enisaslan/ea01/hw/doc/Screenshot_20250719_232026.png

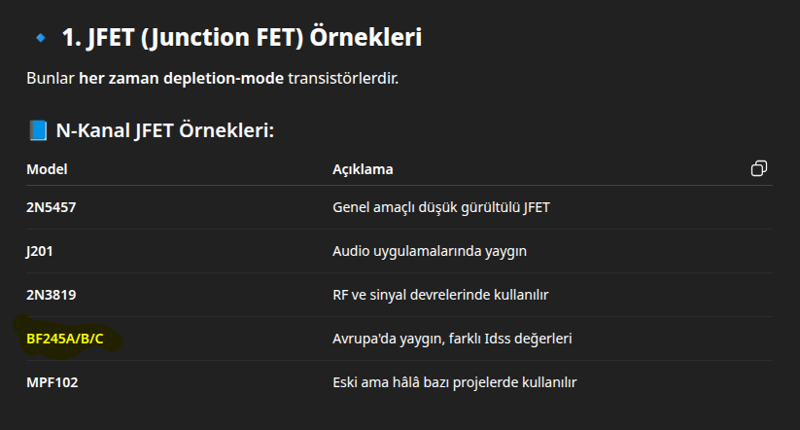
hw/doc/Screenshot_20250719_232026.png
