enisaslan/ea01/hw/ea01/3dModels/User Library-ABM3-2.stp

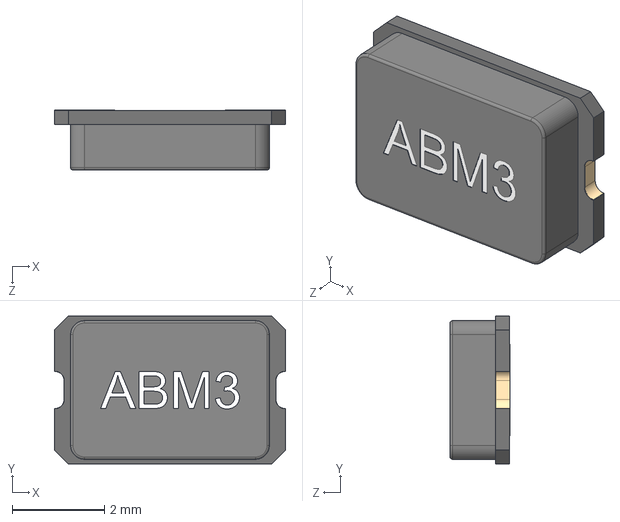
[picture p2: CAD file, 2025-09-29]
hw/ea01/3dModels/User Library-ABM3-2.stp
5.00 x 3.20 x 1.30 mm
