enisaslan/ea01/hw/ea01/3dModels/terminal_blocks_a-tb508-tc02.stp

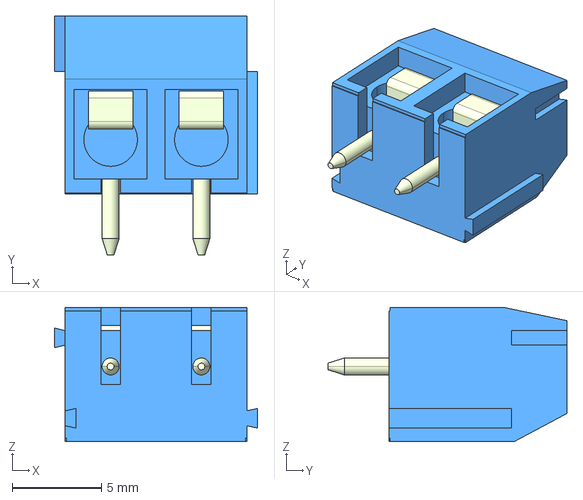
[picture p3: CAD file, 2025-09-29]
hw/ea01/3dModels/terminal_blocks_a-tb508-tc02.stp
11.4 x 13.3 x 7.50 mm
