enisaslan/ea01/hw/ea01/3dModels/terminal_blocks_a-tb508vj02h.stp

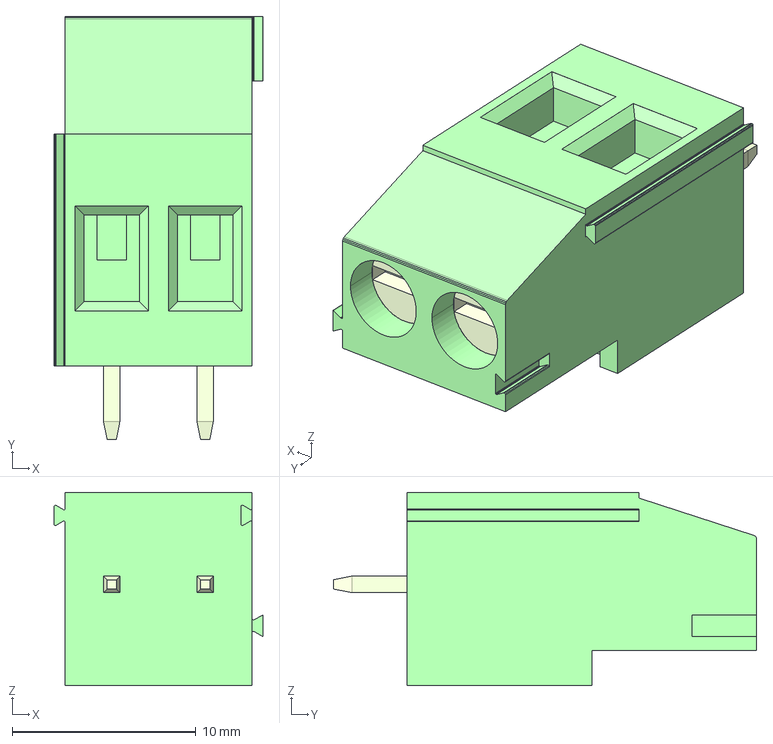
[picture p4: CAD file, 2025-09-29]
hw/ea01/3dModels/terminal_blocks_a-tb508vj02h.stp
11.4 x 23.0 x 10.5 mm
