enisaslan/ea01/hw/ea01/3dModels/a-usbsb.stp

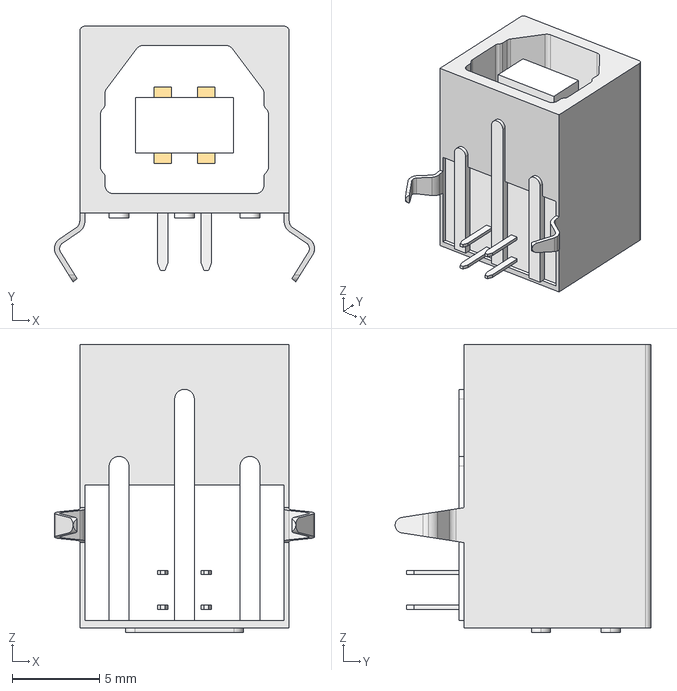
[picture p5: CAD file, 2025-09-29]
hw/ea01/3dModels/a-usbsb.stp
14.9 x 14.7 x 16.5 mm
