enisaslan/ea01/hw/ea01/3dModels/terminal_blocks_a-tb508-tc03.stp

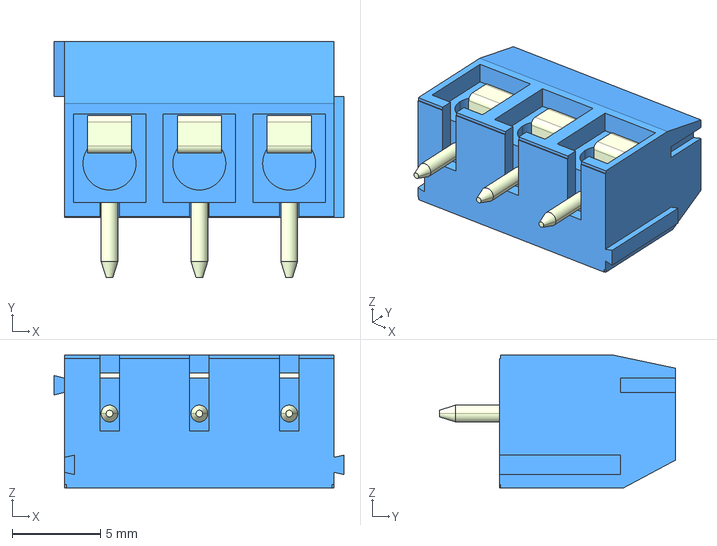
[picture p6: CAD file, 2025-09-29]
hw/ea01/3dModels/terminal_blocks_a-tb508-tc03.stp
16.4 x 13.3 x 7.50 mm
