enisaslan/ea01/hw/ea01/ea01.pdf

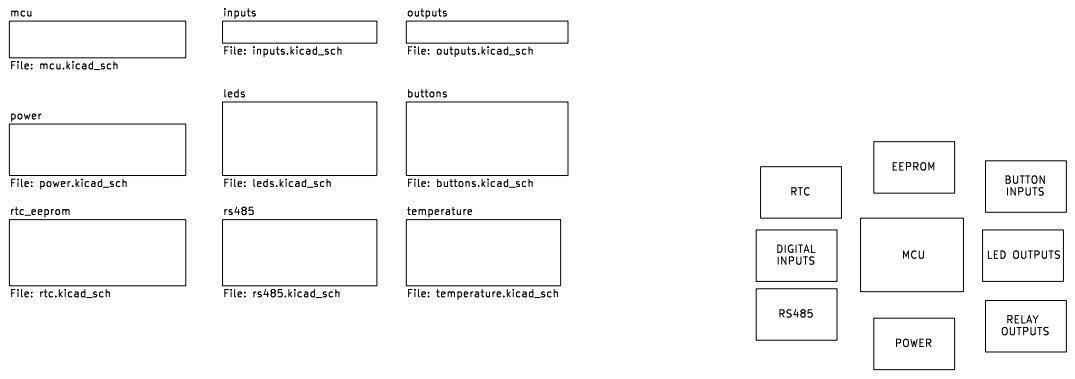
[picture p8: page 1]

power File: power.kicad_sch mcu File: mcu.kicad_sch

Id: 1/10 Title: File: ea01.kicad_sch Sheet: /

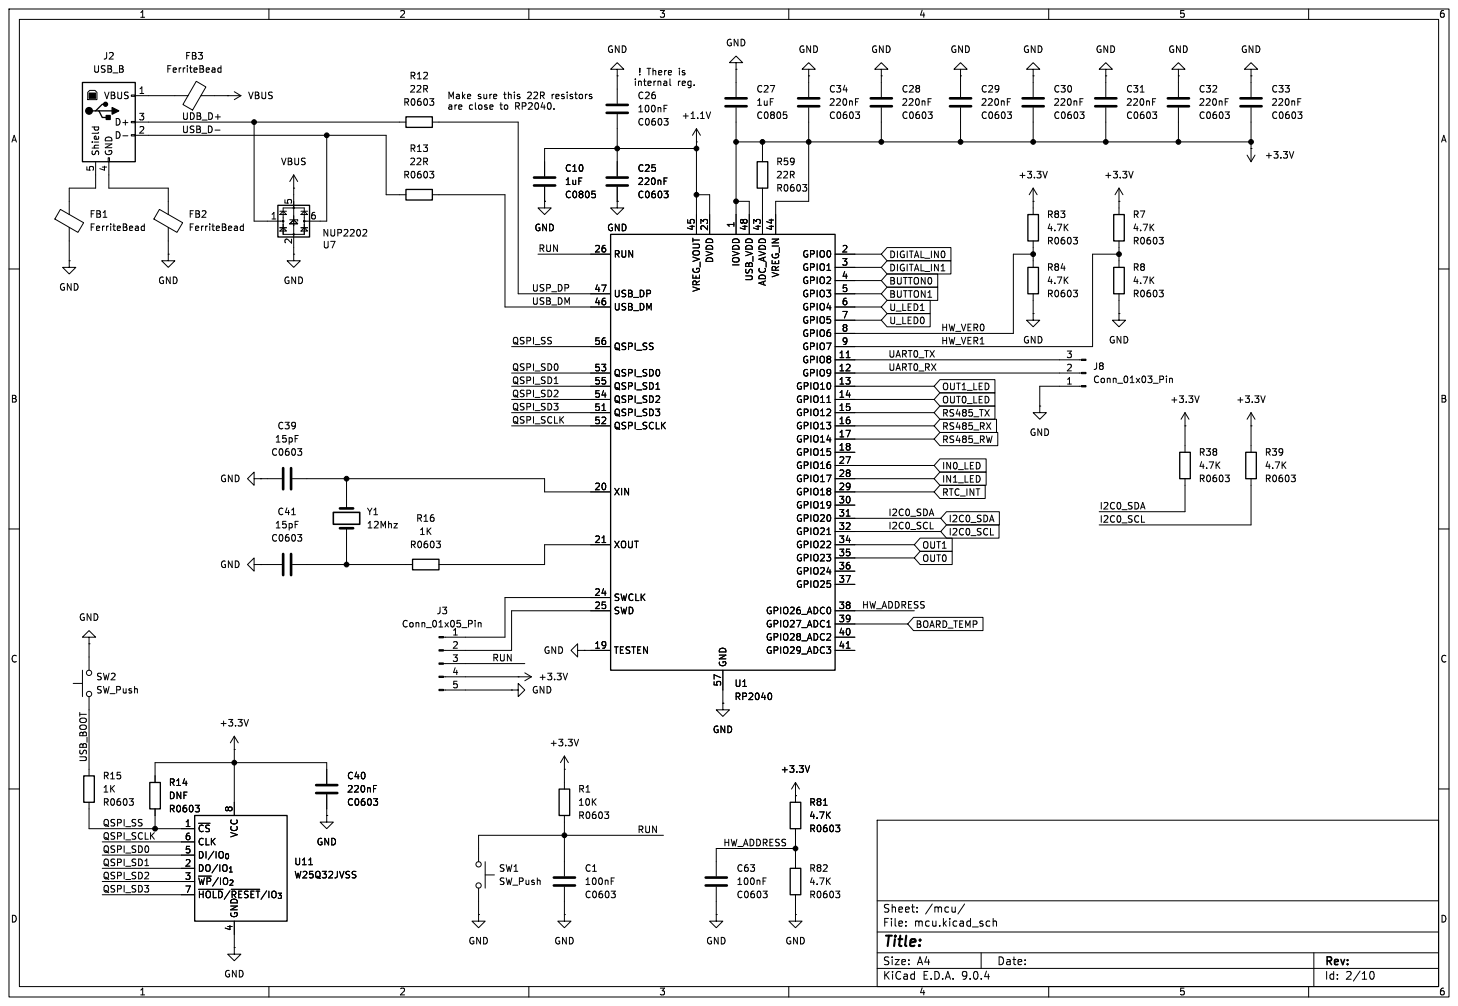
[picture p9: page 2]

Id: 2/10 Title: File: mcu.kicad_sch Sheet: /mcu/

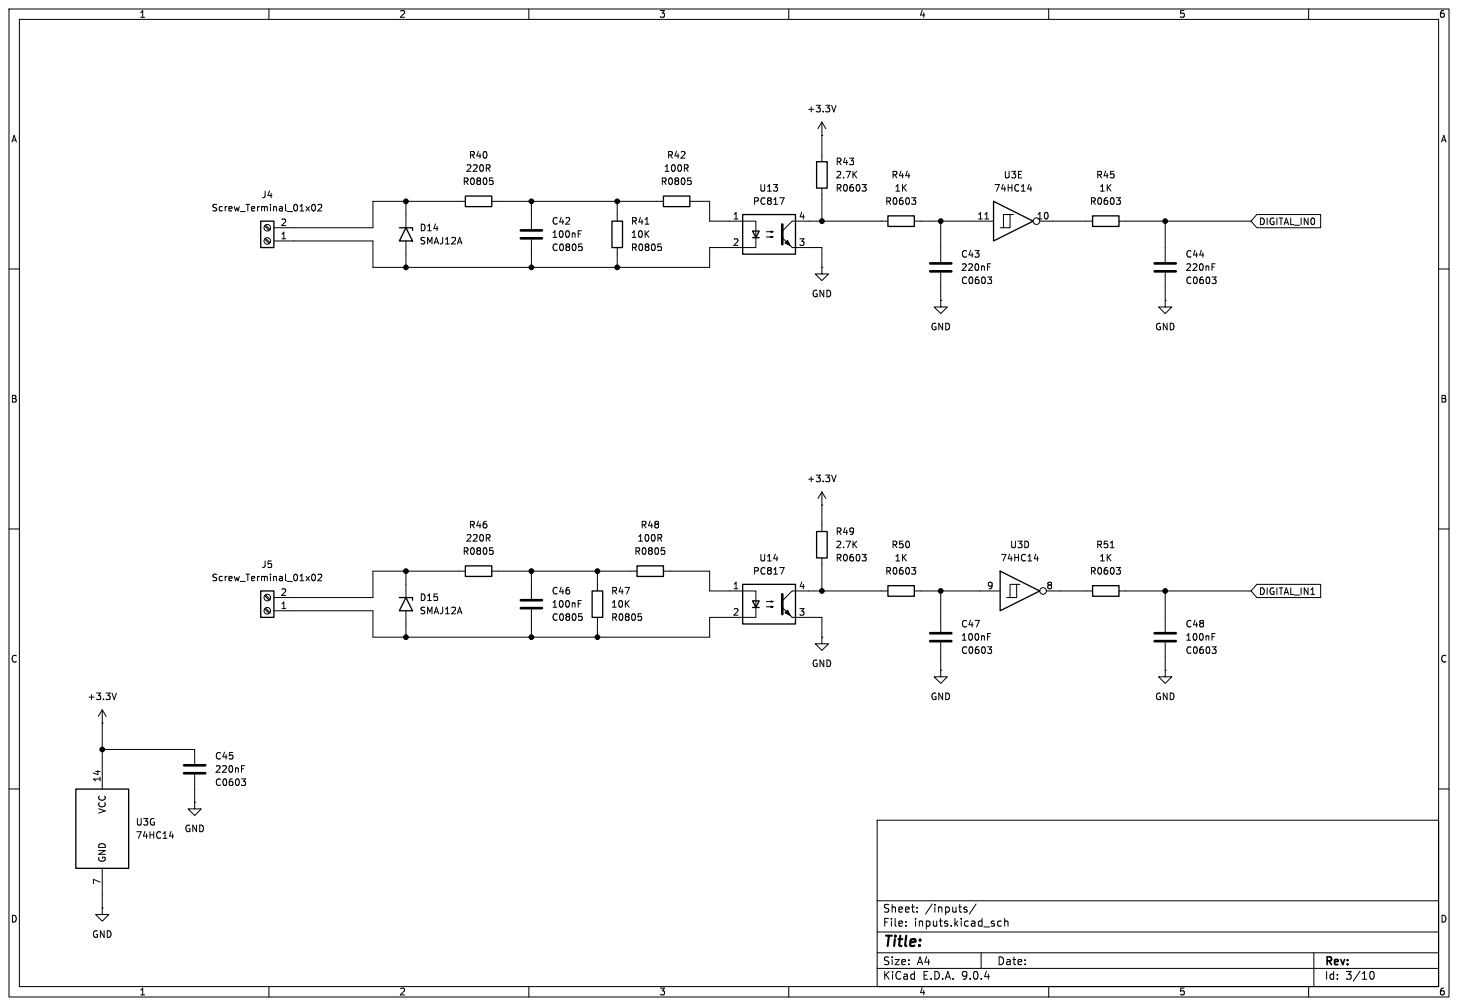
[picture p10: page 3]

Id: 3/10 Title: File: inputs.kicad_sch Sheet: /inputs/

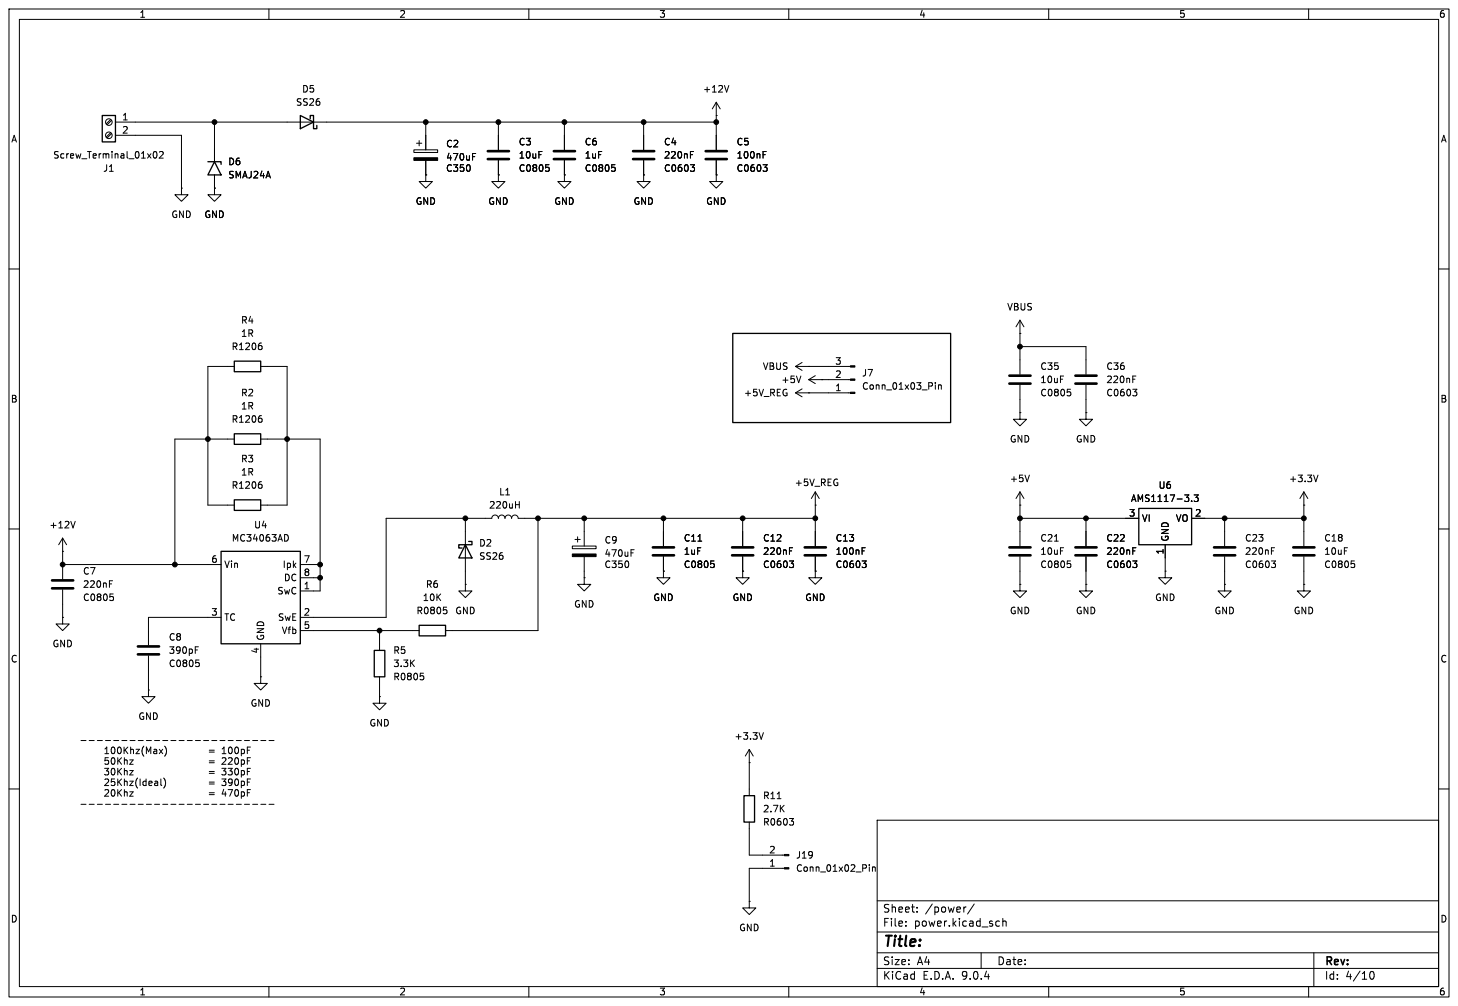
[picture p11: page 4]

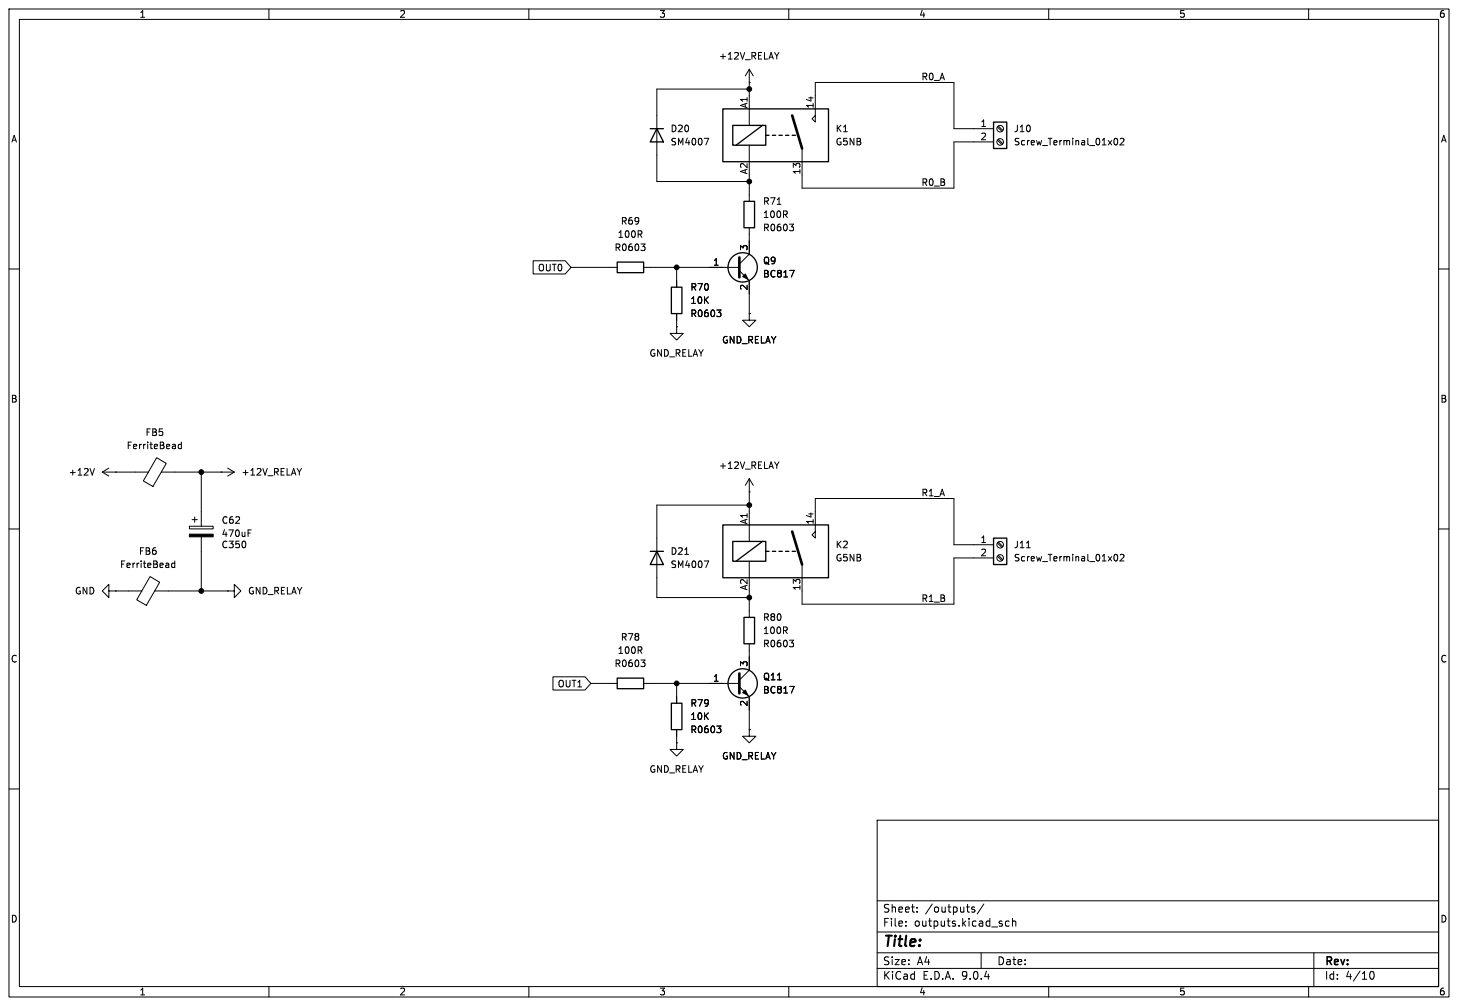
[picture p12: page 5]

Id: 4/10 Title: File: outputs.kicad_sch Sheet: /outputs/

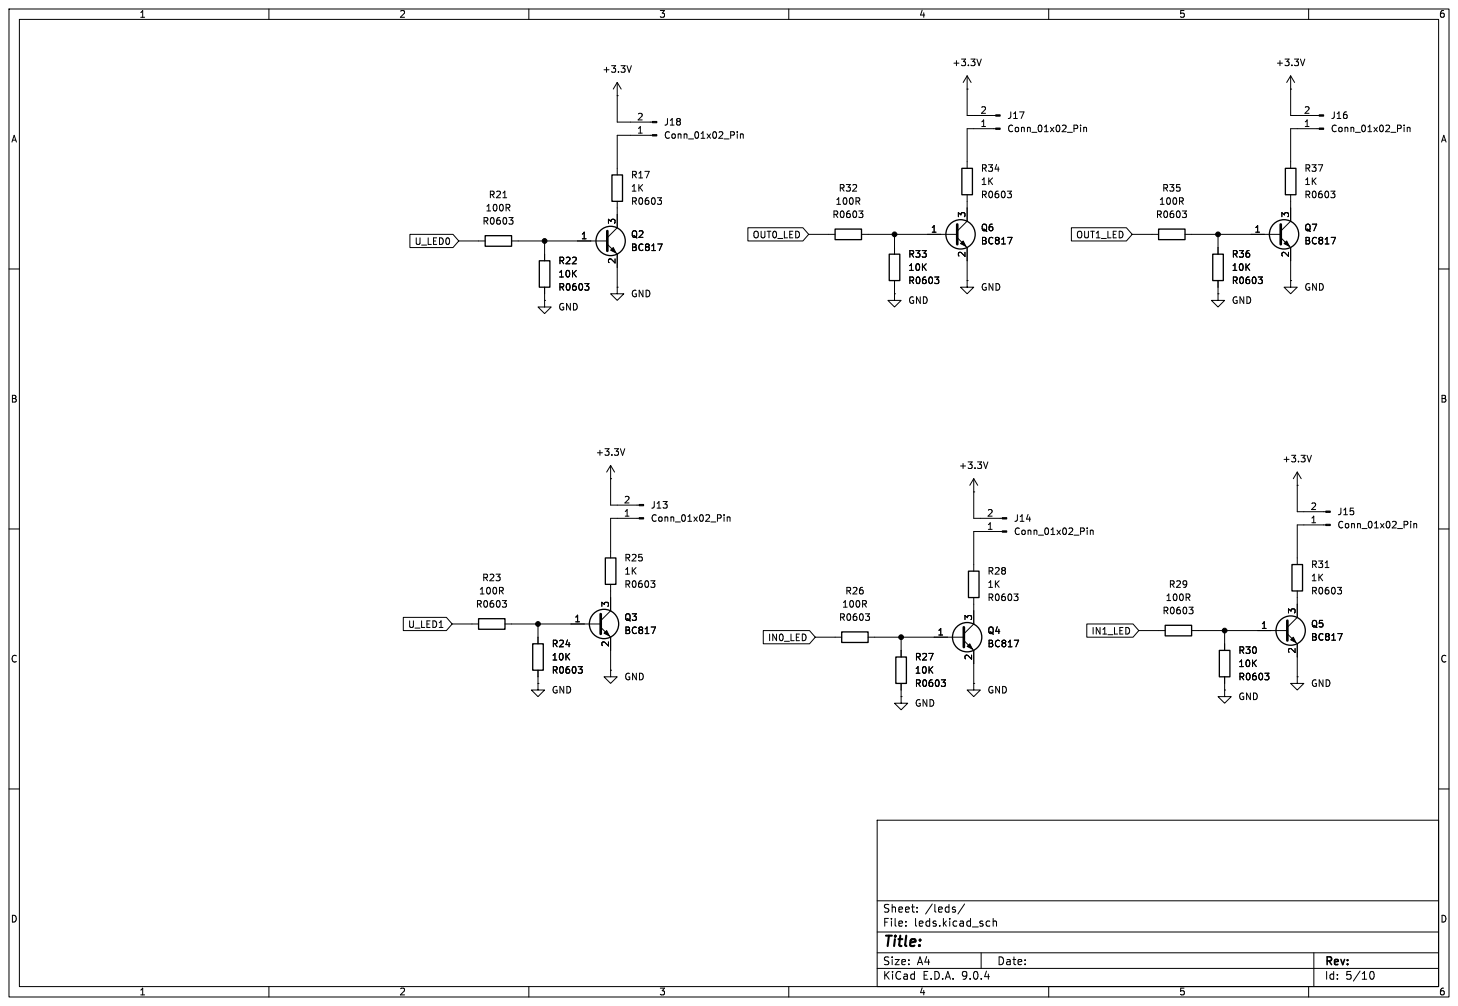
[picture p13: page 6]

Id: 5/10 Title: File: leds.kicad_sch Sheet: /leds/

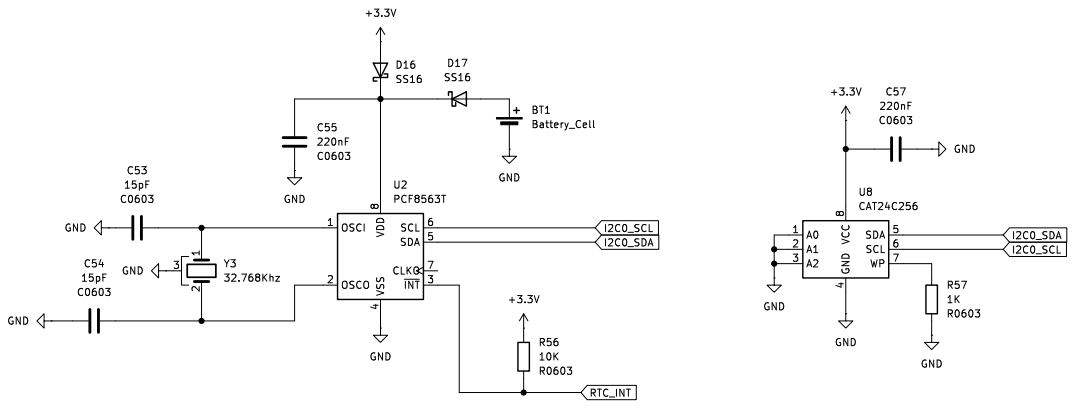
[picture p14: page 7]

4 SCL 6 SDA 5 CLKO 7 ~{INT}3 U2PCF8563T GND

4 SDA 5 SCL 6 WP 7 U8 CAT24C256 R56 GND
I2C0_SDA RTC_INT

File: rtc.kicad_sch Sheet: /rtc_eeprom/ Enis ASLAN

Id: 6/10 Title: RTC & EEPROM

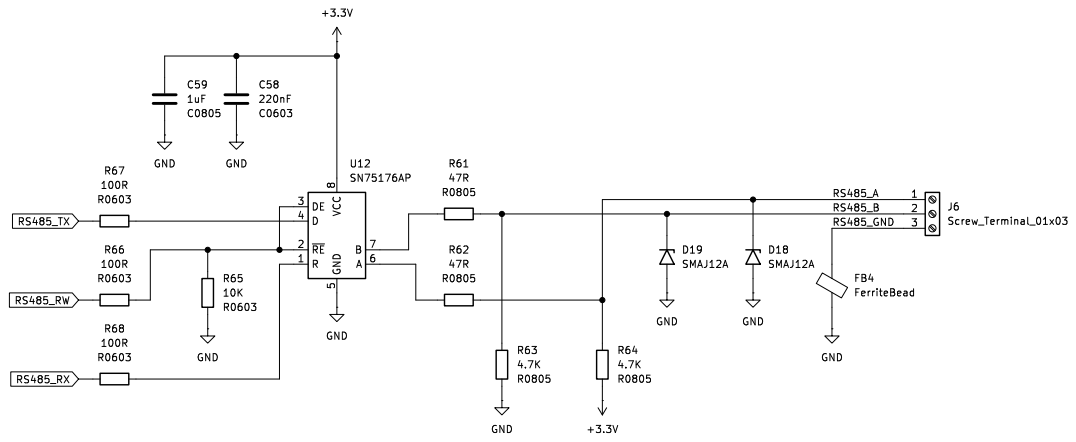
[picture p15: page 8]

Id: 7/10 Title: File: rs485.kicad_sch Sheet: /rs485/

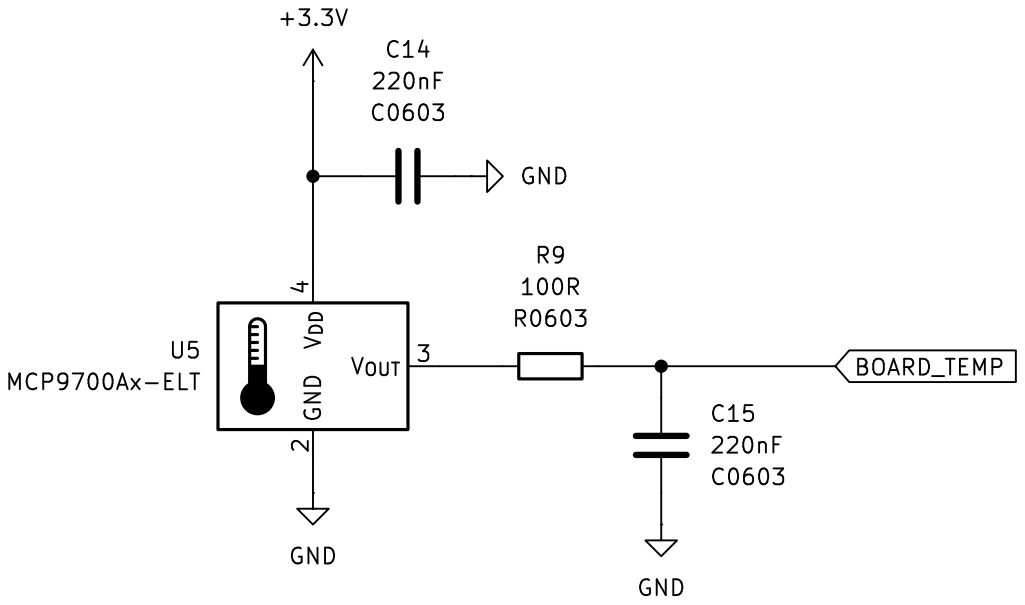
[picture p16: page 9]

Id: 8/10 Title: File: temperature.kicad_sch Sheet: /temperature/ GND

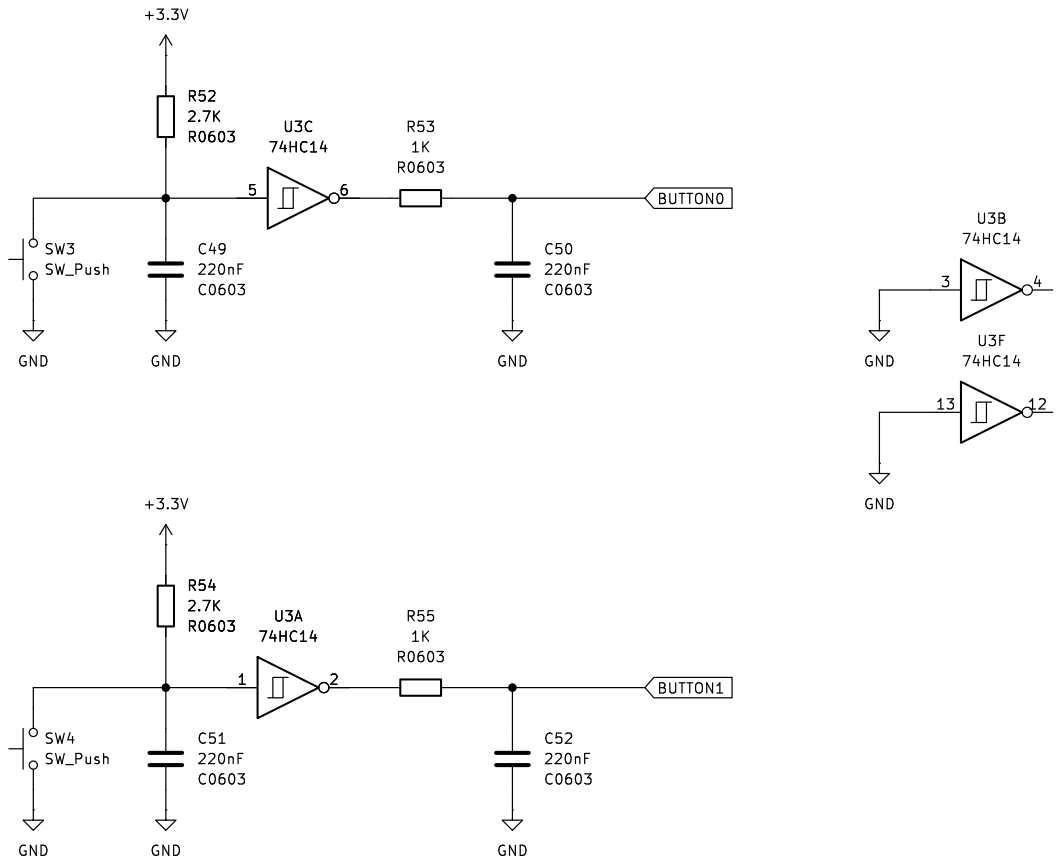
[picture p17: page 10]

Id: 9/10 Title: File: buttons.kicad_sch Sheet: /buttons/ C52
