enisaslan/ea01/hw/ea01/ea01.kicad_pcb

## KiCad design hw/ea01/ea01.kicad_pcb (2025-11-13)

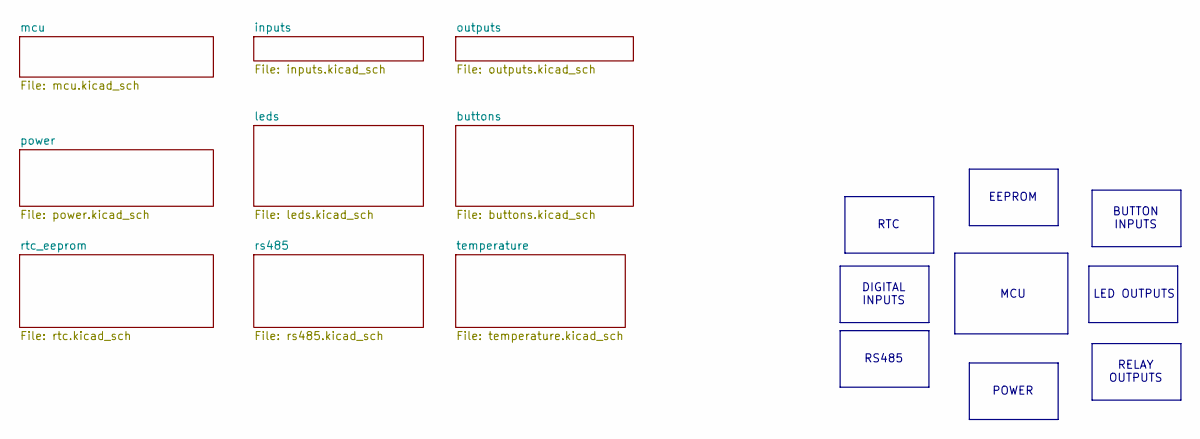
[picture p18: schematic ea01.kicad_sch]

Notes on the sheet:
DIGITAL INPUTS
EEPROM
LED OUTPUTS
MCU
RS485
RTC
BUTTON INPUTS
POWER
RELAY OUTPUTS

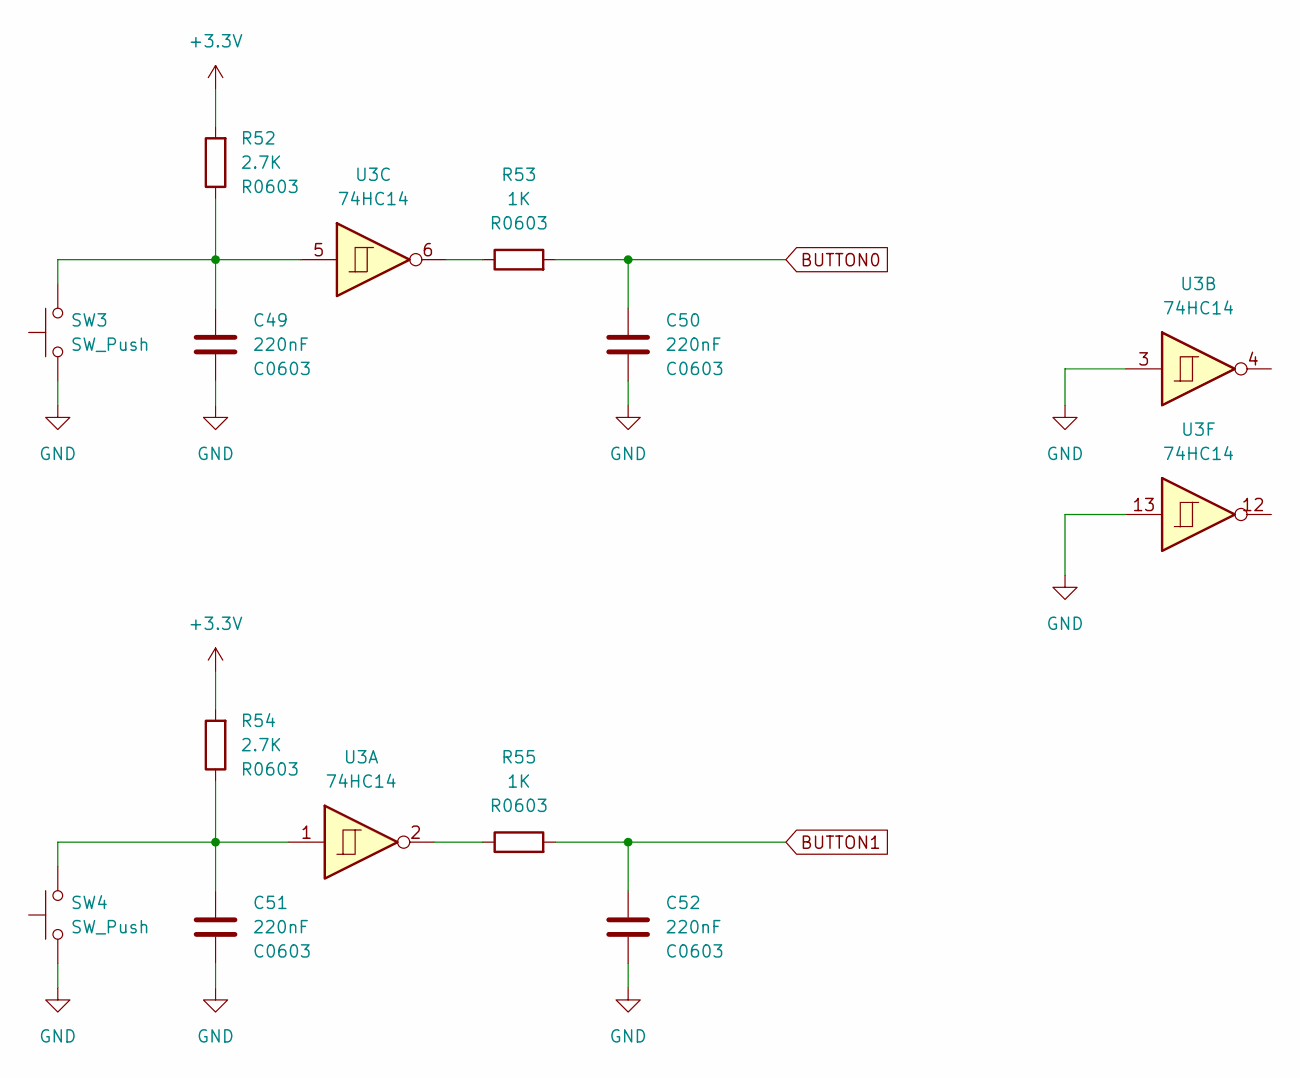
[picture p19: schematic buttons.kicad_sch]

Parts:
C49, C50, C51, C52: 220nF; C_0603_1608Metric
R52, R54: 2.7K; R_0603_1608Metric
R53, R55: 1K; R_0603_1608Metric
SW3, SW4: SW_Push; SW_PUSH_6mm_H5mm
U3: 74HC14; SOIC-14_3.9x8.7mm_P1.27mm

Connections:
+3.3V: R52.2, R54.2; also elsewhere on the board
BUTTON0: C50.1, R53.2; also elsewhere on the board
BUTTON1: C52.1, R55.2; also elsewhere on the board
GND: C49.2, C50.2, C51.2, C52.2, SW3.1, SW4.1, U3.3, U3.13; also elsewhere on the board
unnamed: C49.1, R52.1, SW3.2, U3.5
unnamed: C51.1, R54.1, SW4.2, U3.1
unnamed: R53.1, U3.6
unnamed: R55.1, U3.2

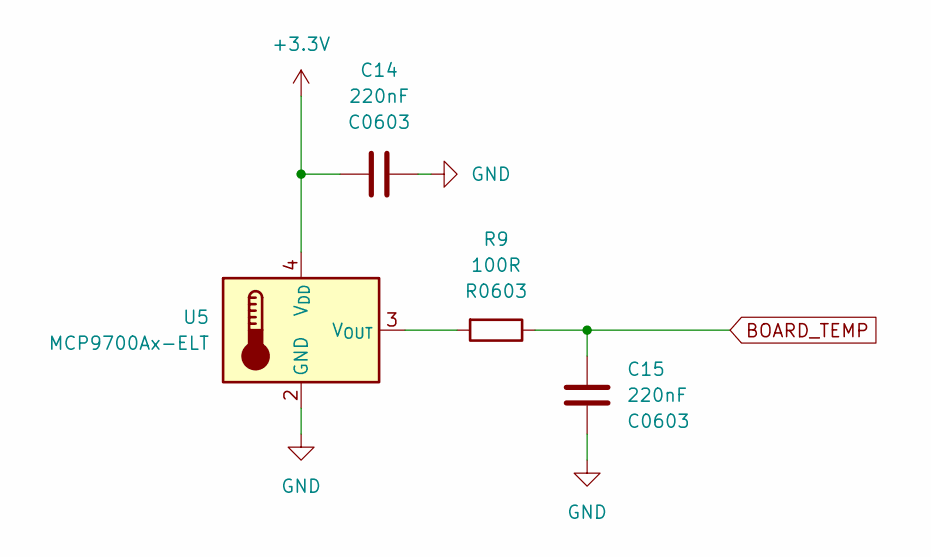
[picture p20: schematic temperature.kicad_sch]

Parts:
C14, C15: 220nF; C_0603_1608Metric
R9: 100R; R_0603_1608Metric
U5: MCP9700Ax-ELT; SOT-353_SC-70-5

Connections:
+3.3V: C14.1, U5.4 (V_{DD}); also elsewhere on the board
BOARD_TEMP: C15.1, R9.1; also elsewhere on the board
GND: C14.2, C15.2, U5.2 (GND); also elsewhere on the board
unnamed: R9.2, U5.3 (V_{OUT})

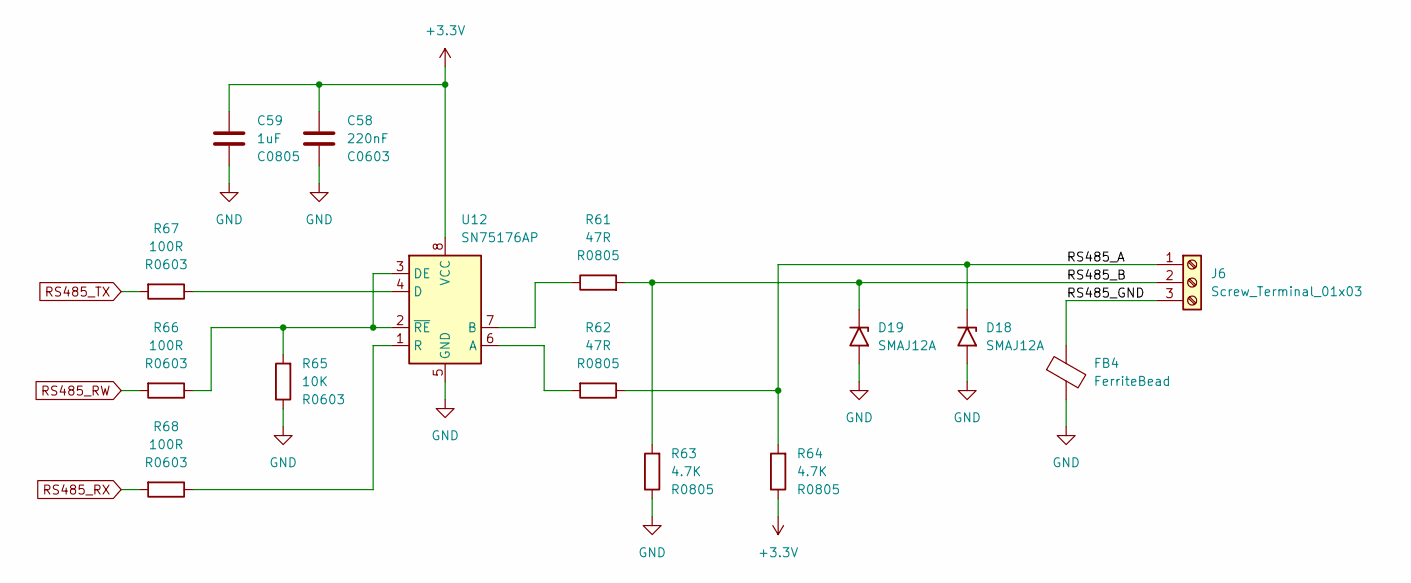
[picture p21: schematic rs485.kicad_sch]

Parts:
C58: 220nF; C_0603_1608Metric
C59: 1uF; C_0805_2012Metric
D18, D19: SMAJ12A; D_SMA
FB4: FerriteBead; R_0805_2012Metric
J6: Screw_Terminal_01x03; TerminalBlock_bornier-3_P5.08mm
R61, R62: 47R; R_0805_2012Metric
R63, R64: 4.7K; R_0805_2012Metric
R65: 10K; R_0603_1608Metric
R66, R67, R68: 100R; R_0603_1608Metric
U12: SN75176AP; DIP-8_W7.62mm

Connections:
+3.3V: C58.1, C59.1, R64.1, U12.8 (VCC); also elsewhere on the board
/rs485/RS485_A: D18.1 (A1), J6.1, R62.1, R64.2
/rs485/RS485_B: D19.1 (A1), J6.2, R61.2, R63.2
/rs485/RS485_GND: FB4.1, J6.3
GND: C58.2, C59.2, D18.2 (A2), D19.2 (A2), FB4.2, R63.1, R65.1, U12.5 (GND); also elsewhere on the board
unnamed: R62.2, U12.6 (A)
unnamed: R61.1, U12.7 (B)
unnamed: R67.1, U12.4 (D)
unnamed: R65.2, R66.1, U12.2 (~RE), U12.3 (DE)
unnamed: R68.1, U12.1 (R)
RS485_RW: R66.2; also elsewhere on the board
RS485_RX: R68.2; also elsewhere on the board
RS485_TX: R67.2; also elsewhere on the board

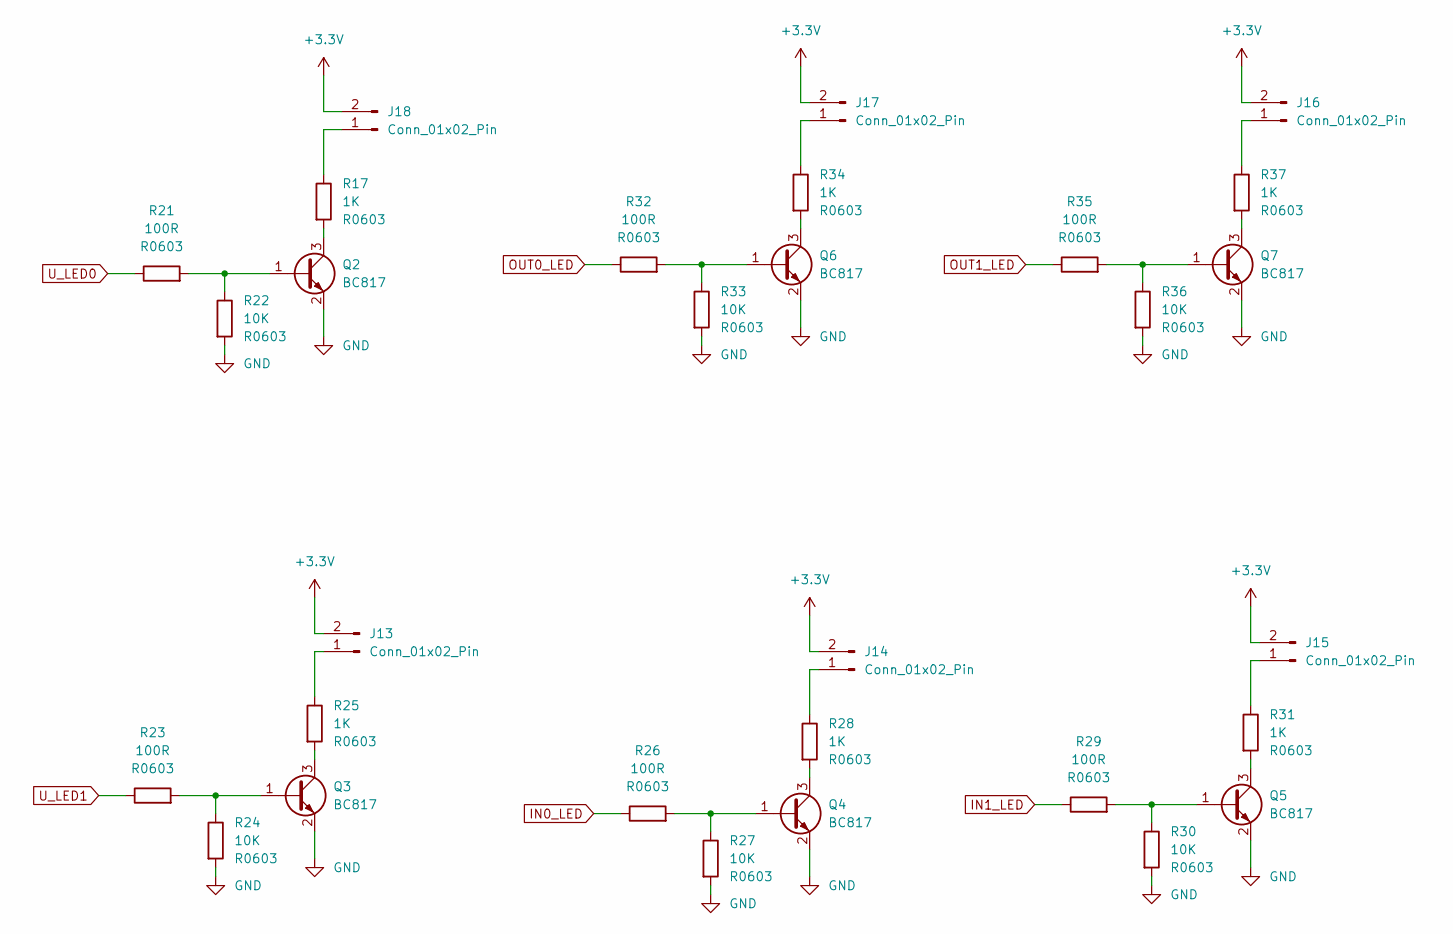
[picture p22: schematic leds.kicad_sch]

Parts:
J13, J14, J15, J16, J17, J18: Conn_01x02_Pin; PinHeader_1x02_P1.27mm_Vertical
Q2, Q3, Q4, Q5, Q6, Q7: BC817; SOT-23
R17, R25, R28, R31, R34, R37: 1K; R_0603_1608Metric
R21, R23, R26, R29, R32, R35: 100R; R_0603_1608Metric
R22, R24, R27, R30, R33, R36: 10K; R_0603_1608Metric

Connections:
+3.3V: J13.2, J14.2, J15.2, J16.2, J17.2, J18.2; also elsewhere on the board
GND: Q2.2 (E), Q3.2 (E), Q4.2 (E), Q5.2 (E), Q6.2 (E), Q7.2 (E), R22.2, R24.2, R27.2, R30.2, R33.2, R36.2; also elsewhere on the board
IN0_LED: R26.1; also elsewhere on the board
IN1_LED: R29.1; also elsewhere on the board
unnamed: J13.1, R25.1
unnamed: J14.1, R28.1
unnamed: J15.1, R31.1
unnamed: J16.1, R37.1
unnamed: J17.1, R34.1
unnamed: J18.1, R17.1
unnamed: Q2.1 (B), R21.2, R22.1
unnamed: Q2.3 (C), R17.2
unnamed: Q3.1 (B), R23.2, R24.1
unnamed: Q3.3 (C), R25.2
unnamed: Q4.1 (B), R26.2, R27.1
unnamed: Q4.3 (C), R28.2
unnamed: Q5.1 (B), R29.2, R30.1
unnamed: Q5.3 (C), R31.2
unnamed: Q6.1 (B), R32.2, R33.1
unnamed: Q6.3 (C), R34.2
unnamed: Q7.1 (B), R35.2, R36.1
unnamed: Q7.3 (C), R37.2
OUT0_LED: R32.1; also elsewhere on the board
OUT1_LED: R35.1; also elsewhere on the board
U_LED0: R21.1; also elsewhere on the board
U_LED1: R23.1; also elsewhere on the board

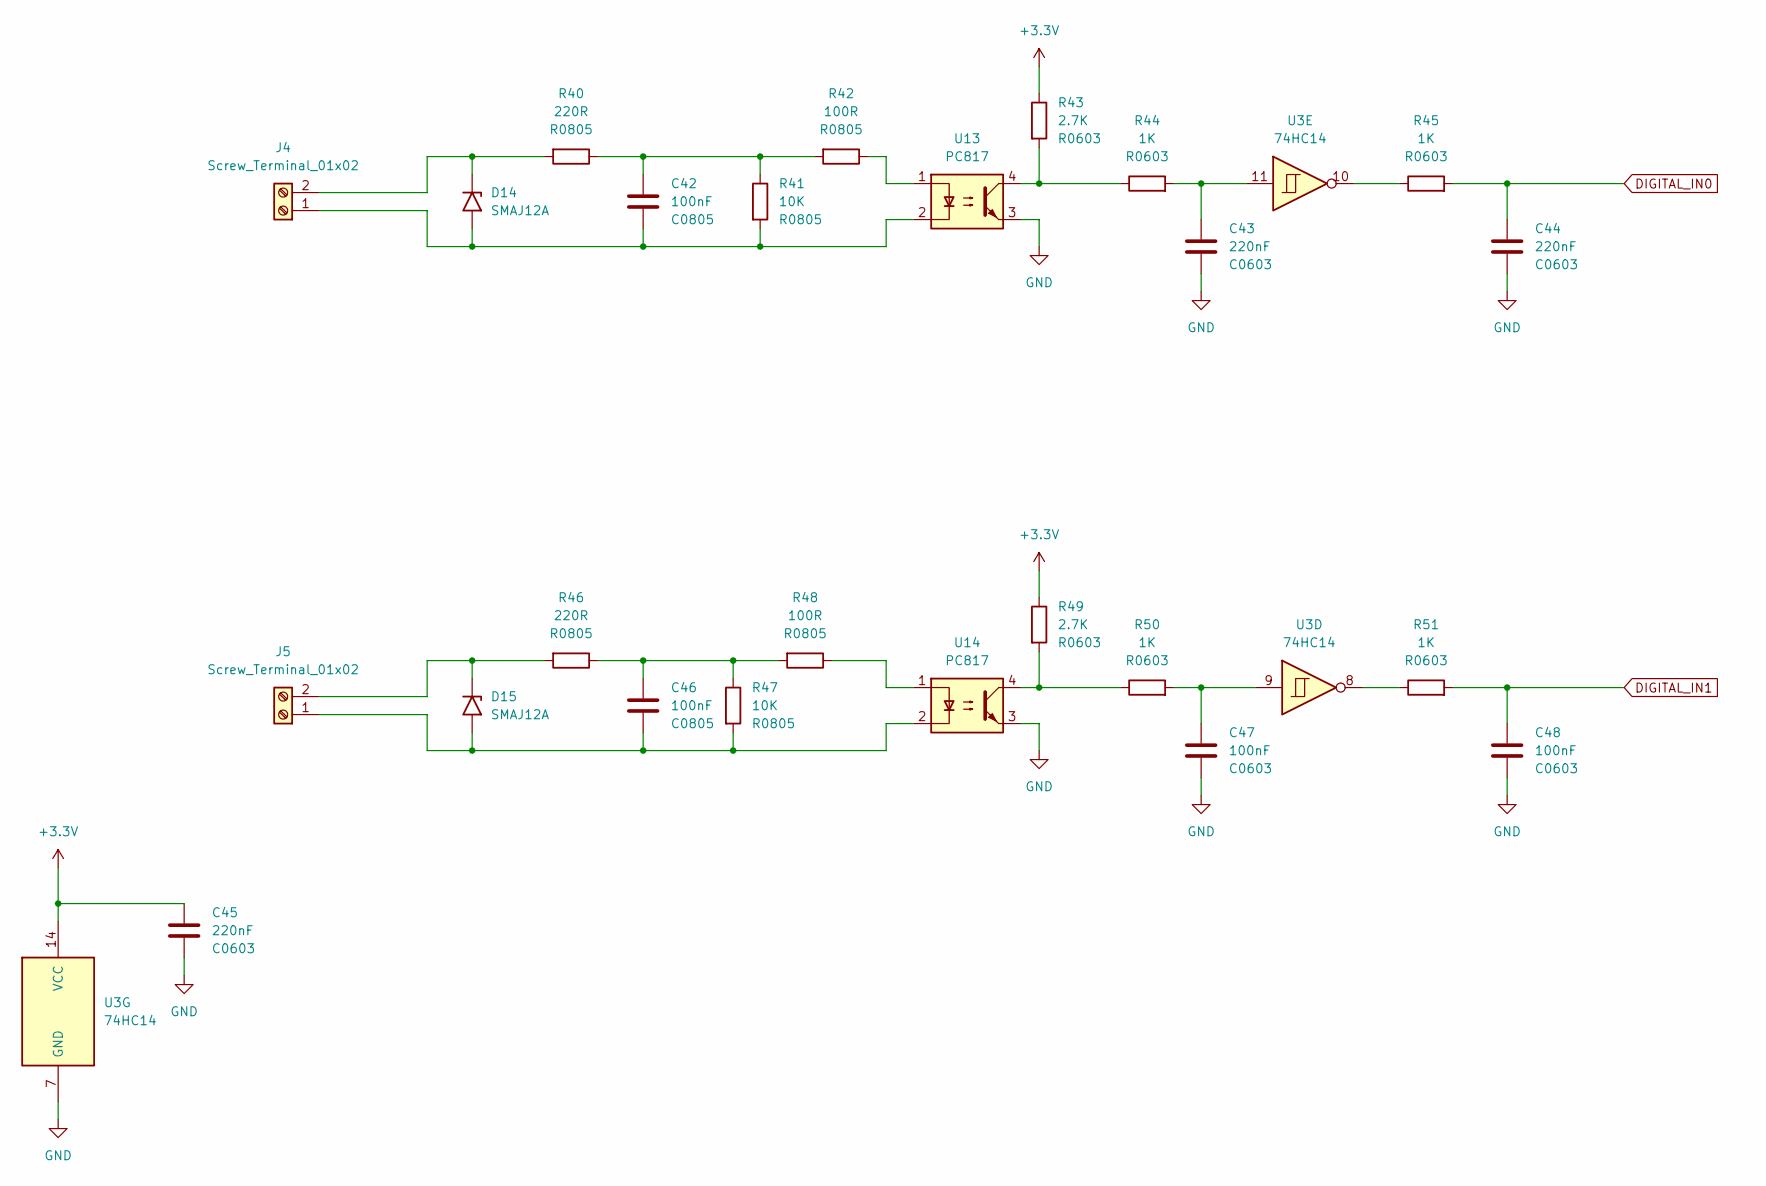
[picture p23: schematic inputs.kicad_sch]

Parts:
C42, C46: 100nF; C_0805_2012Metric
C43, C44, C45: 220nF; C_0603_1608Metric
C47, C48: 100nF; C_0603_1608Metric
D14, D15: SMAJ12A; D_SMA
J4, J5: Screw_Terminal_01x02; TerminalBlock_bornier-2_P5.08mm
R40, R46: 220R; R_0805_2012Metric
R41, R47: 10K; R_0805_2012Metric
R42, R48: 100R; R_0805_2012Metric
R43, R49: 2.7K; R_0603_1608Metric
R44, R45, R50, R51: 1K; R_0603_1608Metric
U3: 74HC14; SOIC-14_3.9x8.7mm_P1.27mm
U13, U14: PC817; DIP-4_W7.62mm

Connections:
+3.3V: C45.1, R43.1, R49.1, U3.14 (VCC); also elsewhere on the board
DIGITAL_IN0: C44.1, R45.2; also elsewhere on the board
DIGITAL_IN1: C48.1, R51.2; also elsewhere on the board
GND: C43.2, C44.2, C45.2, C47.2, C48.2, U3.7 (GND), U13.3, U14.3; also elsewhere on the board
unnamed: C42.1, R40.1, R41.1, R42.2
unnamed: C43.1, R44.2, U3.11
unnamed: C46.1, R46.1, R47.1, R48.2
unnamed: C47.1, R50.2, U3.9
unnamed: D14.1 (A1), J4.2, R40.2
unnamed: C42.2, D14.2 (A2), J4.1, R41.2, U13.2
unnamed: D15.1 (A1), J5.2, R46.2
unnamed: C46.2, D15.2 (A2), J5.1, R47.2, U14.2
unnamed: R42.1, U13.1
unnamed: R43.2, R44.1, U13.4
unnamed: R45.1, U3.10
unnamed: R48.1, U14.1
unnamed: R49.2, R50.1, U14.4
unnamed: R51.1, U3.8

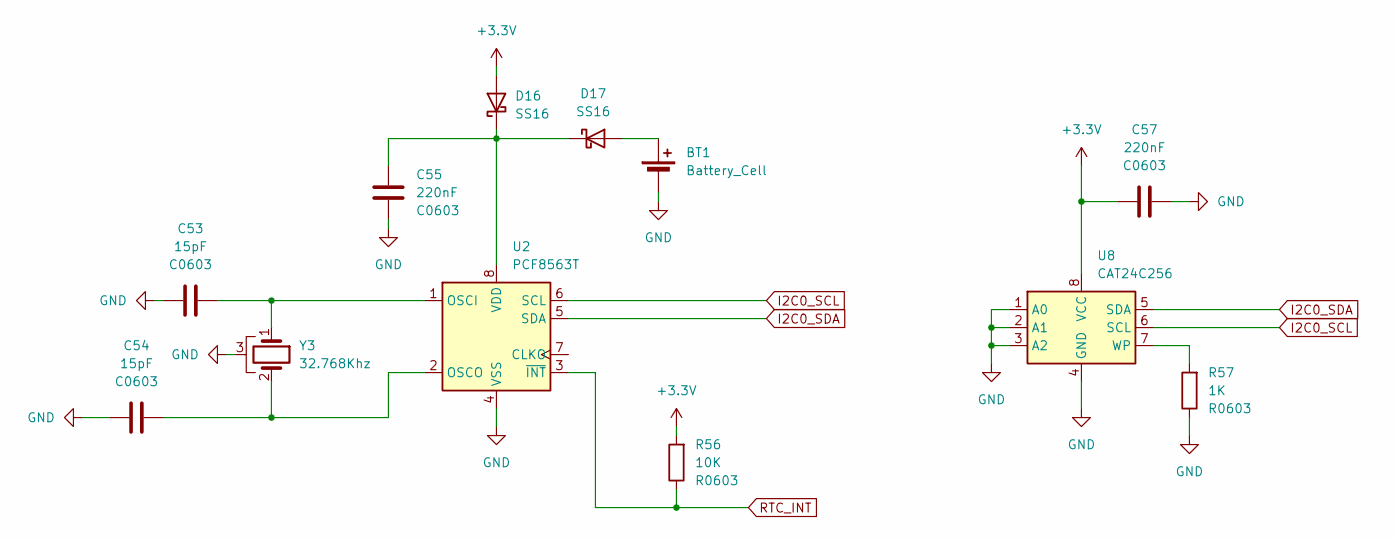
[picture p24: schematic rtc.kicad_sch, RTC & EEPROM]

Parts:
BT1: Battery_Cell; PinHeader_1x02_P2.54mm_Vertical
C53, C54: 15pF; C_0603_1608Metric
C55, C57: 220nF; C_0603_1608Metric
D16, D17: SS16; D_MiniMELF
R56: 10K; R_0603_1608Metric
R57: 1K; R_0603_1608Metric
U2: PCF8563T; SOIC-8_3.9x4.9mm_P1.27mm
U8: CAT24C256; SOIC-8_3.9x4.9mm_P1.27mm
Y3: 32.768Khz; Crystal_C38-LF_D3.0mm_L8.0mm_Horizontal_1EP_style1

Connections:
+3.3V: C57.1, D16.2 (A), R56.2, U8.8 (VCC); also elsewhere on the board
GND: BT1.2 (-), C53.1, C54.1, C55.2, C57.2, R57.1, U2.4 (VSS), U8.1 (A0), U8.2 (A1), U8.3 (A2), U8.4 (GND), Y3.3; also elsewhere on the board
I2C0_SCL: U2.6 (SCL), U8.6 (SCL); also elsewhere on the board
I2C0_SDA: U2.5 (SDA), U8.5 (SDA); also elsewhere on the board
unnamed: BT1.1 (+), D17.2 (A)
unnamed: C55.1, D16.1 (K), D17.1 (K), U2.8 (VDD)
unnamed: C53.2, U2.1 (OSCI), Y3.1
unnamed: C54.2, U2.2 (OSCO), Y3.2
unnamed: R57.2, U8.7 (WP)
RTC_INT: R56.1, U2.3 (~INT); also elsewhere on the board

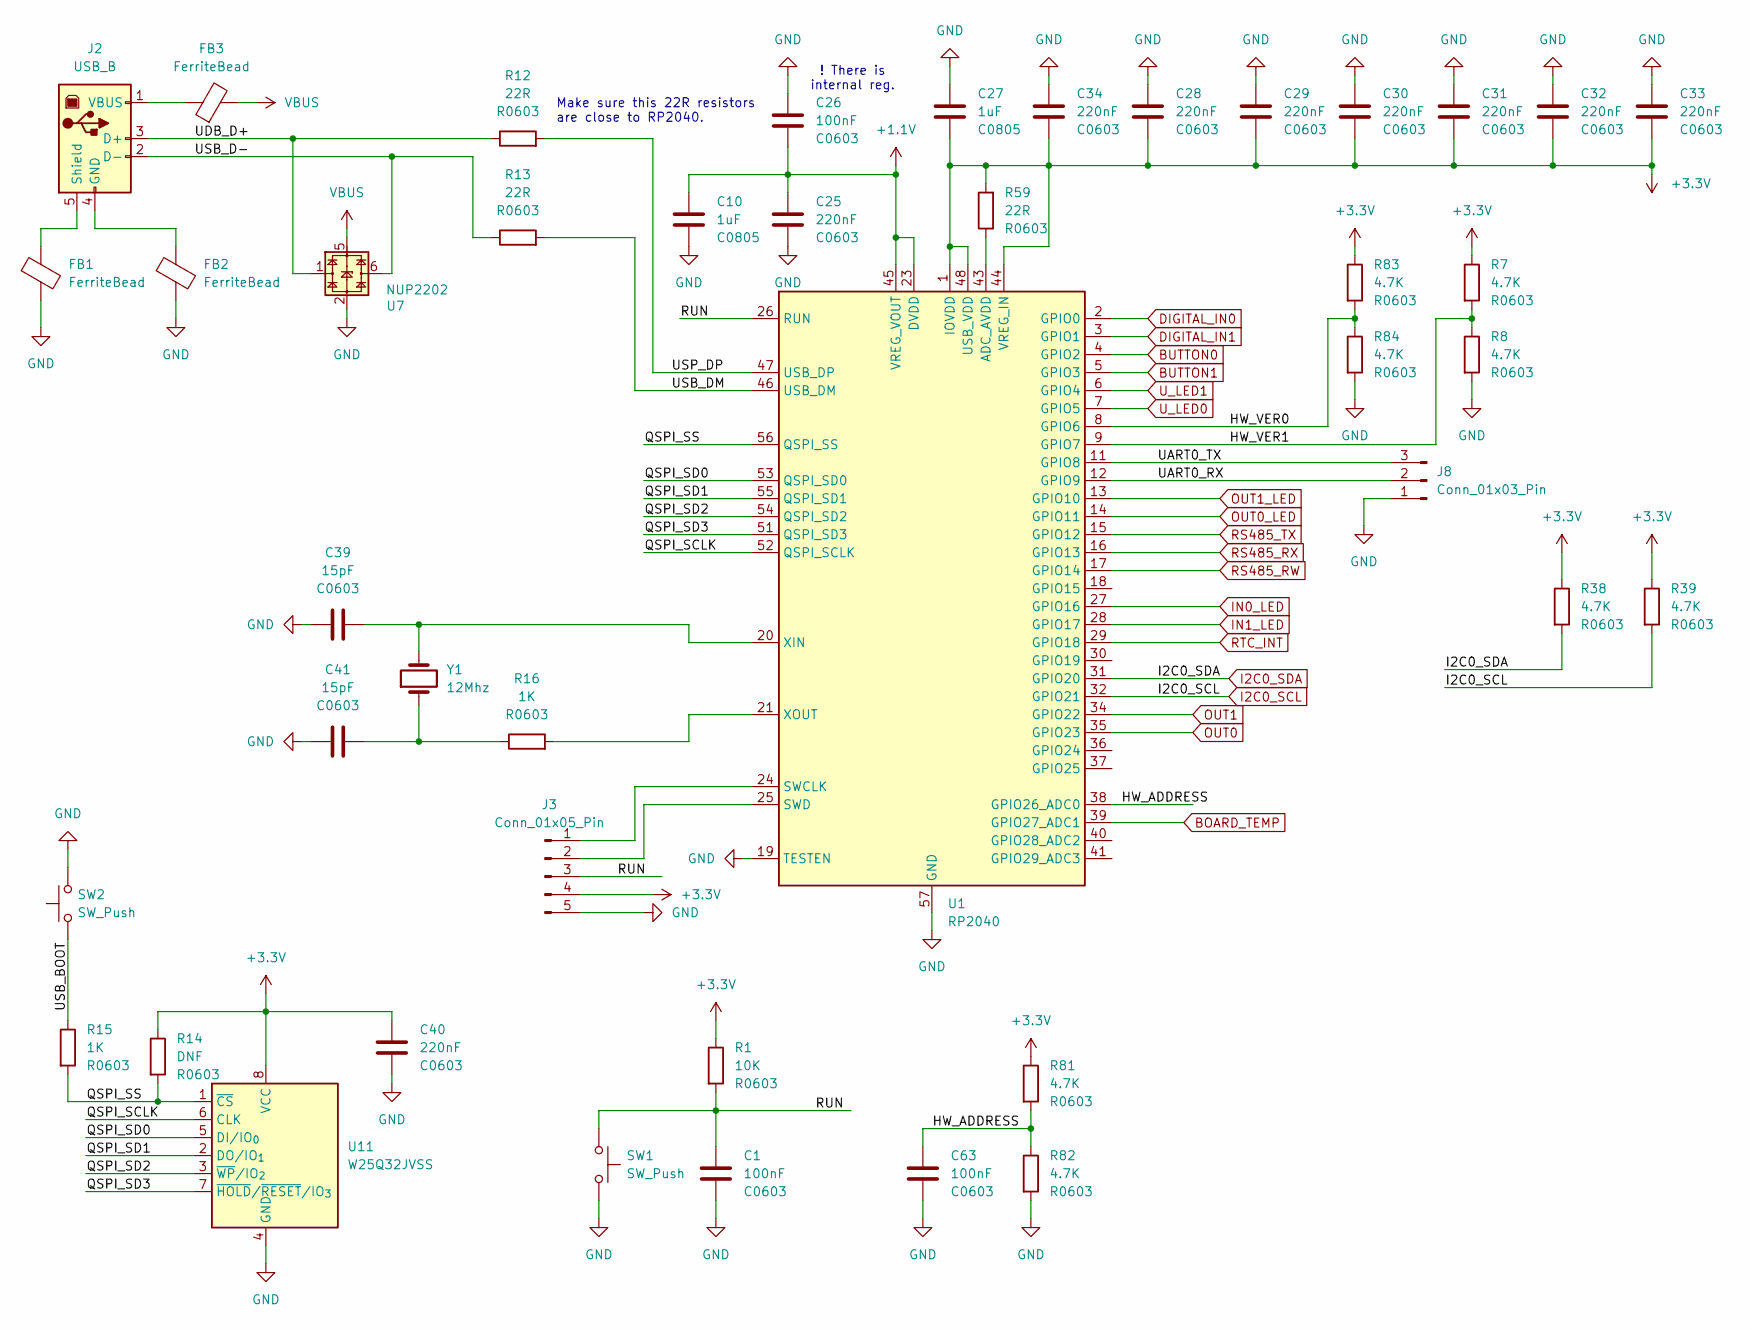
[picture p25: schematic mcu.kicad_sch]

Parts:
C1, C26, C63: 100nF; C_0603_1608Metric
C10, C27: 1uF; C_0805_2012Metric
C25, C28, C29, C30, C31, C32, C33, C34, C40: 220nF; C_0603_1608Metric
C39, C41: 15pF; C_0603_1608Metric
FB1, FB2, FB3: FerriteBead; R_0805_2012Metric
J2: USB_B; USB_B_OST_USB-B1HSxx_Horizontal
J3: Conn_01x05_Pin; PinHeader_1x05_P2.54mm_Vertical
J8: Conn_01x03_Pin; PinHeader_1x03_P2.54mm_Vertical
R1: 10K; R_0603_1608Metric
R7, R8, R38, R39, R81, R82, R83, R84: 4.7K; R_0603_1608Metric
R12, R13, R59: 22R; R_0603_1608Metric
R14: DNF; R_0603_1608Metric
R15, R16: 1K; R_0603_1608Metric
SW1, SW2: SW_Push; SW_Tactile_SPST_Angled_PTS645Vx83-2LFS
U1: RP2040; QFN-56-1EP_7x7mm_P0.4mm_EP3.2x3.2mm
U7: NUP2202; SOT-363_SC-70-6
U11: W25Q32JVSS; SOIC-8_5.3x5.3mm_P1.27mm
Y1: 12Mhz; Crystal_SMD_Abracon_ABM3-2Pin_5.0x3.2mm

Connections:
+1.1V: C10.1, C25.1, C26.2, U1.23 (DVDD), U1.45 (VREG_VOUT), U1.50 (DVDD)
+3.3V: C27.2, C28.2, C29.2, C30.2, C31.2, C32.2, C33.2, C34.2, C40.1, J3.4, R1.1, R7.1, R14.1, R38.1, R39.1, R59.2, R81.1, R83.1, U1.1 (IOVDD), U1.10 (IOVDD), U1.22 (IOVDD), U1.33 (IOVDD), U1.42 (IOVDD), U1.44 (VREG_IN), U1.48 (USB_VDD), U1.49 (IOVDD), U11.8 (VCC); also elsewhere on the board
/mcu/HW_ADDRESS: C63.1, R81.2, R82.1, U1.38 (GPIO26_ADC0)
/mcu/HW_VER0: R83.2, R84.1, U1.8 (GPIO6)
/mcu/HW_VER1: R7.2, R8.1, U1.9 (GPIO7)
/mcu/QSPI_SCLK: U1.52 (QSPI_SCLK), U11.6 (CLK)
/mcu/QSPI_SD0: U1.53 (QSPI_SD0), U11.5 (DI/IO_{0})
/mcu/QSPI_SD1: U1.55 (QSPI_SD1), U11.2 (DO/IO_{1})
/mcu/QSPI_SD2: U1.54 (QSPI_SD2), U11.3 (~WP/IO_{2})
/mcu/QSPI_SD3: U1.51 (QSPI_SD3), U11.7 (~HOLD/~RESET/IO_{3})
/mcu/QSPI_SS: R14.2, R15.2, U1.56 (QSPI_SS), U11.1 (~CS)
/mcu/RUN: C1.1, J3.3, R1.2, SW1.1, U1.26 (RUN)
/mcu/UART0_RX: J8.2, U1.12 (GPIO9)
/mcu/UART0_TX: J8.3, U1.11 (GPIO8)
/mcu/UDB_D+: J2.3 (D+), R12.1, U7.1
/mcu/USB_BOOT: R15.1, SW2.1
/mcu/USB_D-: J2.2 (D-), R13.1, U7.6
/mcu/USB_DM: R13.2, U1.46 (USB_DM)
/mcu/USP_DP: R12.2, U1.47 (USB_DP)
BOARD_TEMP: U1.39 (GPIO27_ADC1); also elsewhere on the board
BUTTON0: U1.4 (GPIO2); also elsewhere on the board
BUTTON1: U1.5 (GPIO3); also elsewhere on the board
DIGITAL_IN0: U1.2 (GPIO0); also elsewhere on the board
DIGITAL_IN1: U1.3 (GPIO1); also elsewhere on the board
GND: C1.2, C10.2, C25.2, C26.1, C27.1, C28.1, C29.1, C30.1, C31.1, C32.1, C33.1, C34.1, C39.1, C40.2, C41.1, C63.2, FB1.2, FB2.2, J3.5, J8.1, R8.2, R82.2, R84.2, SW1.2, SW2.2, U1.19 (TESTEN), U1.57 (GND), U7.2, U11.4 (GND); also elsewhere on the board
I2C0_SCL: R39.2, U1.32 (GPIO21); also elsewhere on the board
I2C0_SDA: R38.2, U1.31 (GPIO20); also elsewhere on the board
IN0_LED: U1.27 (GPIO16); also elsewhere on the board
IN1_LED: U1.28 (GPIO17); also elsewhere on the board
unnamed: C41.2, R16.1, Y1.1
unnamed: FB2.1, J2.4 (GND)
unnamed: FB1.1, J2.5 (Shield)
unnamed: FB3.1, J2.1 (VBUS)
unnamed: J3.1, U1.24 (SWCLK)
unnamed: J3.2, U1.25 (SWD)
unnamed: R59.1, U1.43 (ADC_AVDD)
unnamed: C39.2, U1.20 (XIN), Y1.2
unnamed: R16.2, U1.21 (XOUT)
OUT0: U1.35 (GPIO23); also elsewhere on the board
OUT0_LED: U1.14 (GPIO11); also elsewhere on the board
OUT1: U1.34 (GPIO22); also elsewhere on the board
OUT1_LED: U1.13 (GPIO10); also elsewhere on the board
RS485_RW: U1.17 (GPIO14); also elsewhere on the board
RS485_RX: U1.16 (GPIO13); also elsewhere on the board
RS485_TX: U1.15 (GPIO12); also elsewhere on the board
RTC_INT: U1.29 (GPIO18); also elsewhere on the board
U_LED0: U1.7 (GPIO5); also elsewhere on the board
U_LED1: U1.6 (GPIO4); also elsewhere on the board
VBUS: FB3.2, U7.5; also elsewhere on the board

Notes on the sheet:
! There is internal reg.
Make sure this 22R resistors are close to RP2040.

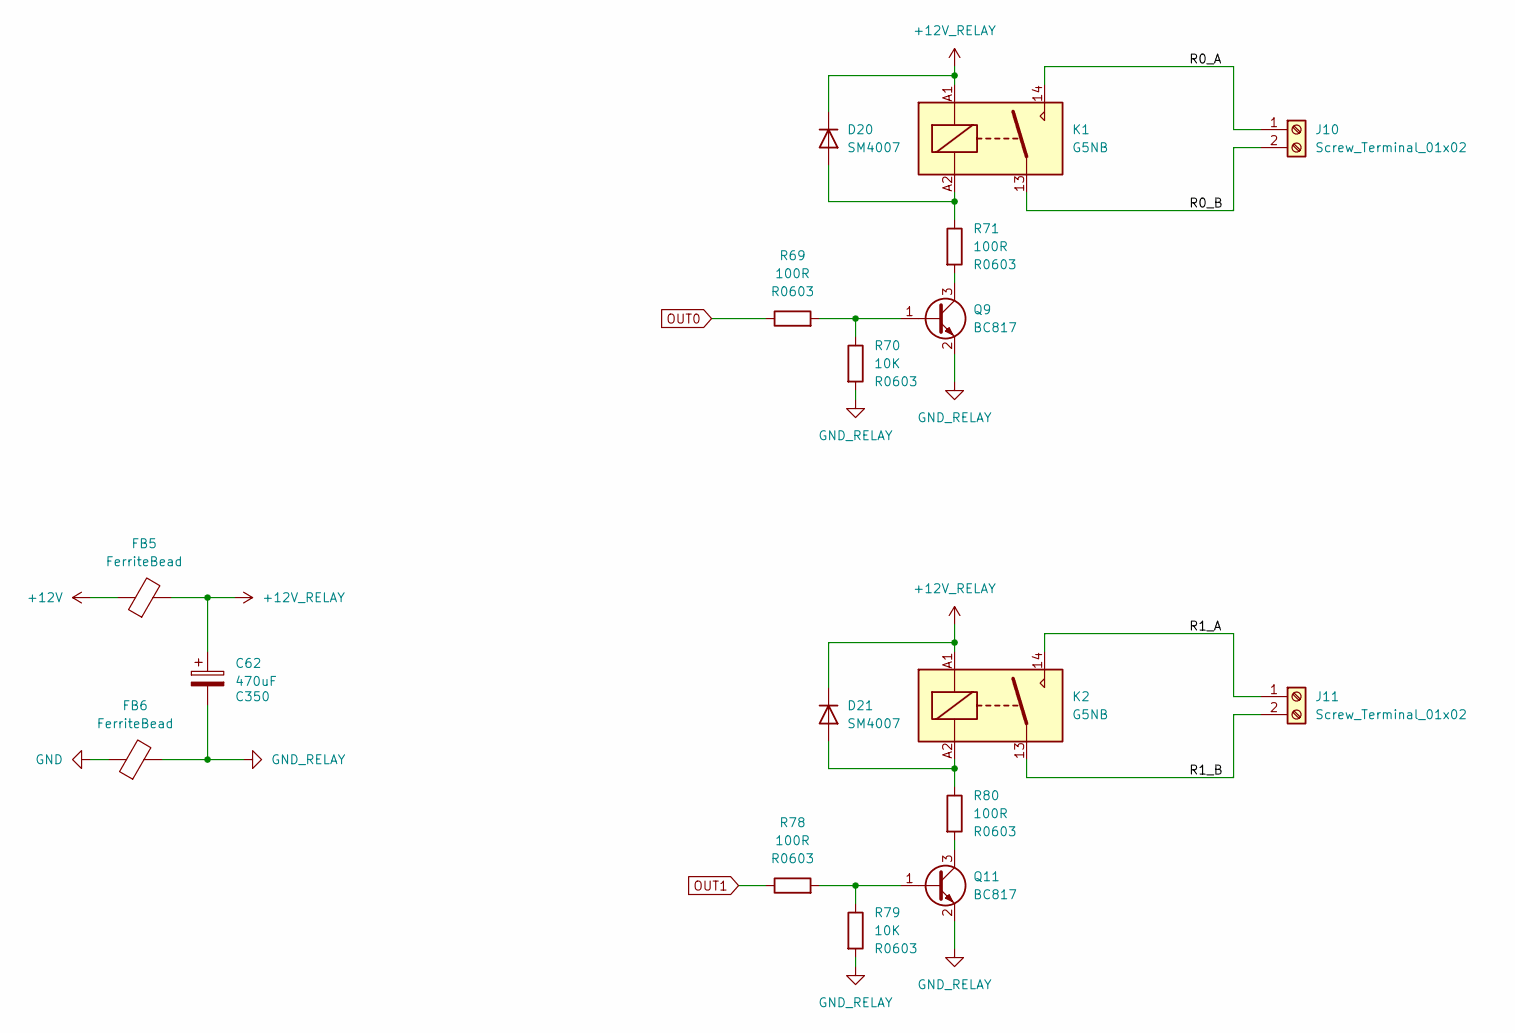
[picture p26: schematic outputs.kicad_sch]

Parts:
C62: 470uF; CP_Radial_D8.0mm_P3.50mm
D20, D21: SM4007; D_MELF
FB5, FB6: FerriteBead; R_0805_2012Metric
J10, J11: Screw_Terminal_01x02; TerminalBlock_bornier-2_P5.08mm
K1, K2: G5NB; Relay_SPST_Omron_G5NB
Q9, Q11: BC817; SOT-23
R69, R71, R78, R80: 100R; R_0603_1608Metric
R70, R79: 10K; R_0603_1608Metric

Connections:
+12V: FB5.1; also elsewhere on the board
+12V_RELAY: C62.1, D20.1 (K), D21.1 (K), FB5.2, K1.A1, K2.A1
/outputs/R0_A: J10.1, K1.14
/outputs/R0_B: J10.2, K1.13
/outputs/R1_A: J11.1, K2.14
/outputs/R1_B: J11.2, K2.13
GND: FB6.1; also elsewhere on the board
GND_RELAY: C62.2, FB6.2, Q9.2 (E), Q11.2 (E), R70.2, R79.2
unnamed: D20.2 (A), K1.A2, R71.1
unnamed: D21.2 (A), K2.A2, R80.1
unnamed: Q9.1 (B), R69.2, R70.1
unnamed: Q9.3 (C), R71.2
unnamed: Q11.1 (B), R78.2, R79.1
unnamed: Q11.3 (C), R80.2
OUT0: R69.1; also elsewhere on the board
OUT1: R78.1; also elsewhere on the board

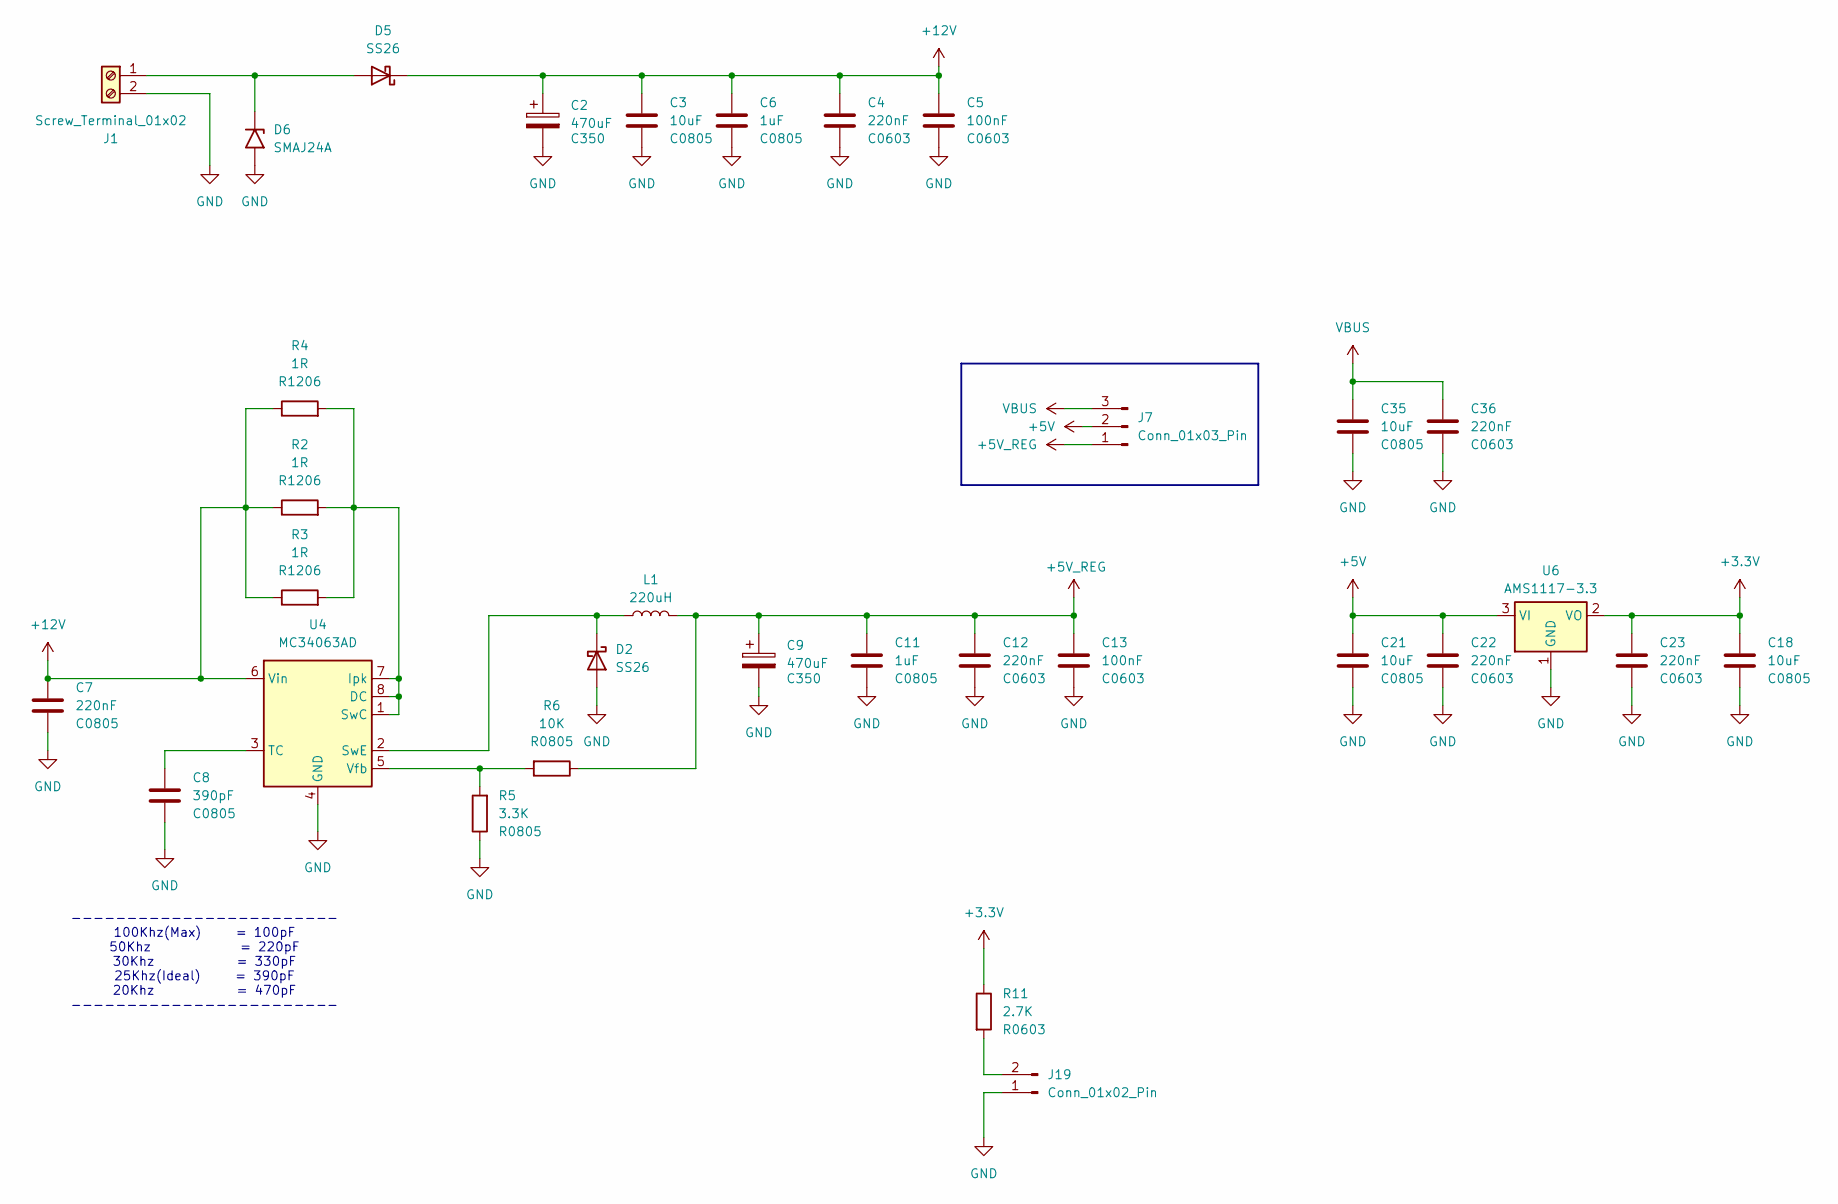
[picture p27: schematic power.kicad_sch]

Parts:
C2, C9: 470uF; CP_Radial_D8.0mm_P3.50mm
C3, C18, C21, C35: 10uF; C_0805_2012Metric
C4, C12, C22, C23, C36: 220nF; C_0603_1608Metric
C5, C13: 100nF; C_0603_1608Metric
C6, C11: 1uF; C_0805_2012Metric
C7: 220nF; C_0805_2012Metric
C8: 390pF; C_0805_2012Metric
D2, D5: SS26; D_SMA
D6: SMAJ24A; D_SMA
J1: Screw_Terminal_01x02; TerminalBlock_bornier-2_P5.08mm
J7: Conn_01x03_Pin; PinHeader_1x03_P2.54mm_Vertical
J19: Conn_01x02_Pin; PinHeader_1x02_P1.27mm_Vertical
L1: 220uH; L_Coilcraft_MSS1210-XXX
R2, R3, R4: 1R; R_1206_3216Metric
R5: 3.3K; R_0805_2012Metric
R6: 10K; R_0805_2012Metric
R11: 2.7K; R_0603_1608Metric
U4: MC34063AD; SOIC-8_3.9x4.9mm_P1.27mm
U6: AMS1117-3.3; SOT-223-3_TabPin2

Connections:
+3.3V: C18.1, C23.1, R11.1, U6.2 (VO); also elsewhere on the board
+5V: C21.1, C22.1, J7.2, U6.3 (VI)
+5V_REG: C9.1, C11.1, C12.1, C13.1, J7.1, L1.2, R6.1
+12V: C2.1, C3.1, C4.1, C5.1, C6.1, C7.1, D5.1 (K), R2.1, R3.1, R4.1, U4.6 (Vin); also elsewhere on the board
GND: C2.2, C3.2, C4.2, C5.2, C6.2, C7.2, C8.2, C9.2, C11.2, C12.2, C13.2, C18.2, C21.2, C22.2, C23.2, C35.2, C36.2, D2.2 (A), D6.2 (A2), J1.2, J19.1, R5.1, U4.4 (GND), U6.1 (GND); also elsewhere on the board
unnamed: D2.1 (K), L1.1, U4.2 (SwE)
unnamed: D5.2 (A), D6.1 (A1), J1.1
unnamed: J19.2, R11.2
unnamed: R2.2, R3.2, R4.2, U4.1 (SwC), U4.7 (Ipk), U4.8 (DC)
unnamed: C8.1, U4.3 (TC)
unnamed: R5.2, R6.2, U4.5 (Vfb)
VBUS: C35.1, C36.1, J7.3; also elsewhere on the board

Notes on the sheet:
------------------------ 100Khz(Max) = 100pF 50Khz = 220pF 30Khz = 330pF 25Khz(Ideal) = 390pF 20Khz = 470pF ------------------------

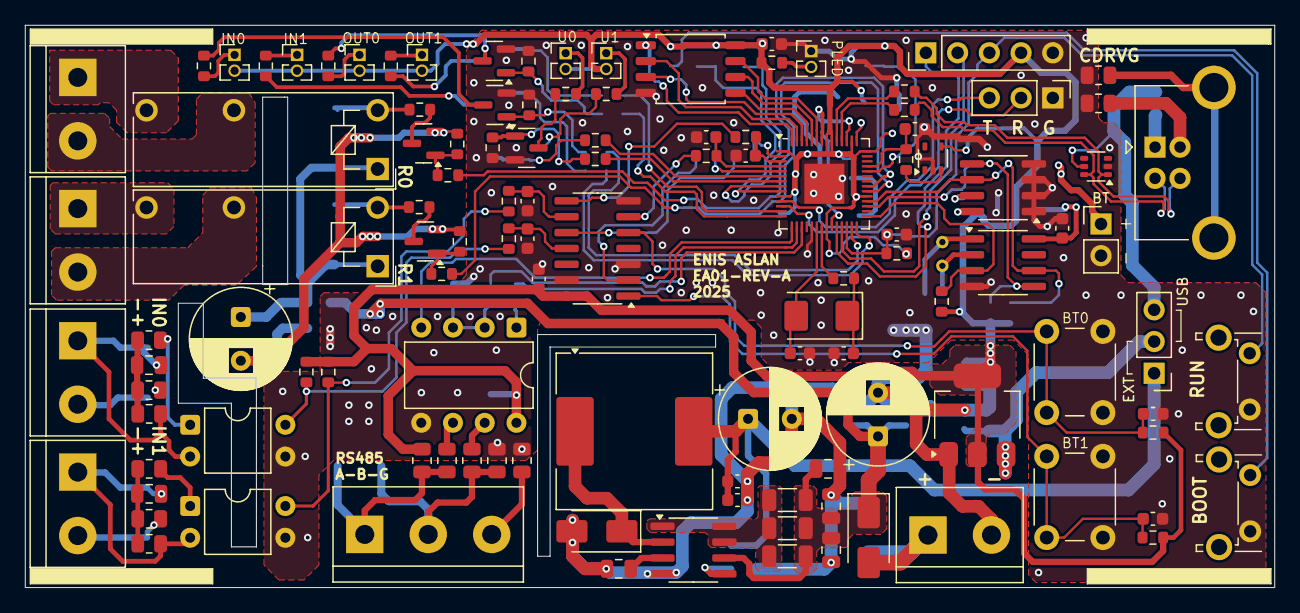
[picture p28: board ea01.kicad_pcb from above]

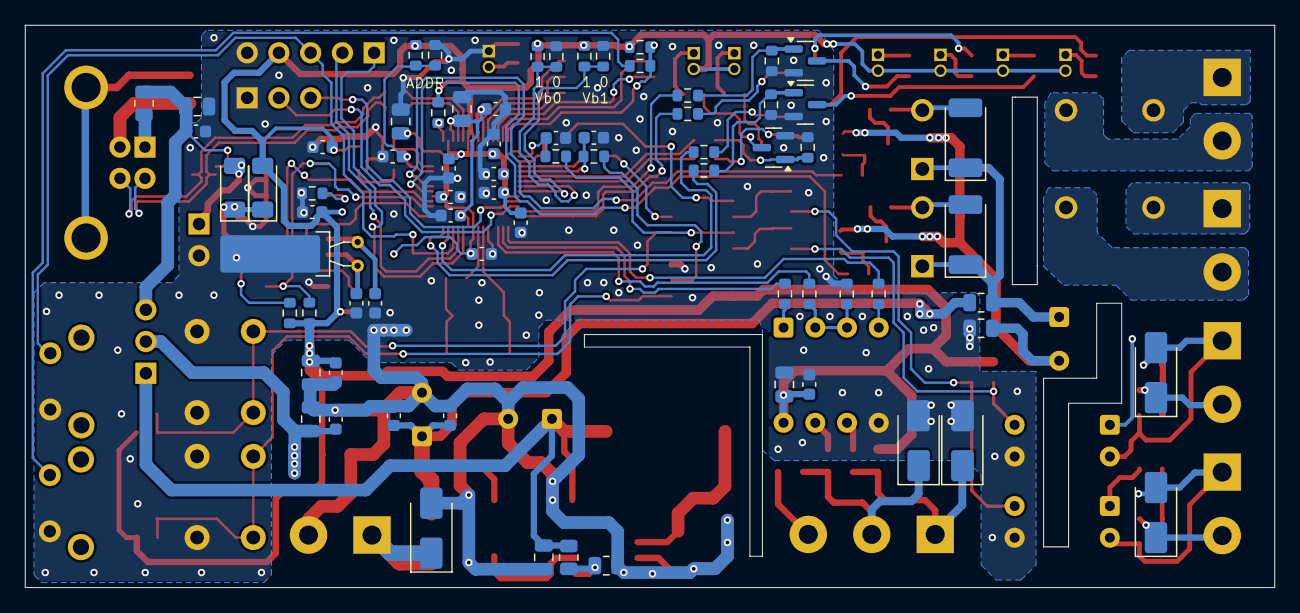
[picture p29: board ea01.kicad_pcb from below]

Board: 2 copper layers, 100.0 x 45.0 mm, 189 parts (72 on the bottom side), 120 nets.
