enisaslan/ea01/(commit log)

2025-07-20 first upload.
    [ea01.kicad_pcb, ea01.kicad_sch, inputs.kicad_sch, io.kicad_sch, leds.kicad_sch, mcu.kicad_sch, outputs.kicad_sch, peripherals.kicad_sch]
2025-07-20 schmatic drawing continue...
    [buttons.kicad_sch, ea01.kicad_sch, inputs.kicad_sch, leds.kicad_sch, mcu.kicad_sch, outputs.kicad_sch, rs485.kicad_sch, rtc.kicad_sch]
2025-07-23 sch refactored
    [leds.kicad_sch, mcu.kicad_sch]
2025-09-02 errors fix for comp fp
    [buttons.kicad_sch, ea01.kicad_pcb, inputs.kicad_sch, leds.kicad_sch, mcu.kicad_sch, outputs.kicad_sch, power.kicad_sch, rs485.kicad_sch]
2025-09-13 pcb drawing continue..
    [ea01.kicad_pcb, mcu.kicad_sch, outputs.kicad_sch, rtc.kicad_sch]
2025-09-19 component placement continue..
    [buttons.kicad_sch, ea01.kicad_pcb, inputs.kicad_sch, leds.kicad_sch, mcu.kicad_sch, outputs.kicad_sch, power.kicad_sch, rs485.kicad_sch]
2025-09-19 placement continue...
    [buttons.kicad_sch, ea01.kicad_pcb, inputs.kicad_sch, leds.kicad_sch, mcu.kicad_sch, power.kicad_sch, rtc.kicad_sch]
2025-09-19 placement optimization and review continue
    [ea01.kicad_pcb, mcu.kicad_sch, power.kicad_sch]
2025-09-21 placement completed.
    [ea01.kicad_pcb, leds.kicad_sch, power.kicad_sch]
2025-09-21 drawing continue...
    [ea01.kicad_pcb, mcu.kicad_sch, outputs.kicad_sch]
2025-09-26 drawing continue..
    [buttons.kicad_sch, ea01.kicad_pcb, inputs.kicad_sch, leds.kicad_sch, mcu.kicad_sch]
2025-09-28 draw contleted. Not checked yet.
    [ea01.kicad_pcb, mcu.kicad_sch, rs485.kicad_sch]
2025-09-28 gerber files generated..
    [ea01-B_Cu.gbr, ea01-B_Mask.gbr, ea01-B_Paste.gbr, ea01-B_Silkscreen.gbr, ea01-Edge_Cuts.gbr, ea01-F_Cu.gbr, ea01-F_Mask.gbr, ea01-F_Paste.gbr]
2025-09-29 3d models updated
    [User Library-ABM3-2.stp, a-usbsb.stp, buttons.kicad_sch, ea01.kicad_pcb, mcu.kicad_sch, rs485.kicad_sch, terminal_blocks_a-tb508-tc02.stp, terminal_blocks_a-tb508-tc03.stp]
2025-09-30 Order Data git add .!
    [ea01-B_Cu.gbr, ea01-B_Mask.gbr, ea01-B_Paste.gbr, ea01-B_Silkscreen.gbr, ea01-Edge_Cuts.gbr, ea01-F_Cu.gbr, ea01-F_Mask.gbr, ea01-F_Paste.gbr]
2025-11-13 gnd connection update
    [ea01.kicad_pcb]
